desanv01/Flight-Controller-V2/docs/overview.md

# Flight Controller V2

STM32H743VIT6 controller adapted from an open-hardware reference design for externally regulated power, a signal-only OpenESC interface, exact Nano-Fit integration and a pinned ArduPilot target. The repository preserves the hardware adaptation, firmware work and vendor engineering packages.

Engineering prototype. Manufacturer data and a pinned firmware target are available. Neutral firmware build status is recorded separately; powered-board, sensor and flight qualification remain pending.

[Contribution statement](../CONTRIBUTIONS.md) · [Source](../hardware/README.md) · [History](development/timeline.md).
