desanv01/Flight-Controller-V2/docs/portfolio/resume-bullets.md

# Resume-ready project wording

Project: **Flight Controller V2**. Contributor: Desan Vasu. Dates reflect technical records, not employment dates. Fabrication external. Select bullets for the intended role rather than using all of them.

- Adapted an open-hardware STM32H743 controller for externally regulated power, a signal-only ESC boundary and exact Nano-Fit integration.
- Configured and reproduced a pinned ArduPilot target, preserving firmware defaults, source provenance and board-specific interface mappings.
- Reconciled manufacturer BOM/placement data and documented hardware, firmware and props-off validation requirements.

Do not add flight performance, deployment, production reliability or successful powered sensor tests without measured evidence. Original upstream and reference-library work remains separately credited.
