desanv01/Flight-Controller-V2/fabrication/jlcpcb/fabrication/drill-report.txt

Drill report for Flight Controller.kicad_pcb
Created on 2026-10-14T18:28:30

Copper Layer Stackup:
    =============================================================
    L1 :  F.Cu (SIG PWR)            front
    L2 :  In1.Cu (GND)              in1
    L3 :  In2.Cu (SIG PWR)          in2
    L4 :  In3.Cu(GND SIG)           in3
    L5 :  In4.Cu (GND)              in4
    L6 :  B.Cu (SIG PWR)            back

Drill file 'Flight Controller-PTH.drl' contains
    plated through holes:
    =============================================================
    T1  0.250mm  0.0098"  (359 holes))
    T2  0.400mm  0.0157"  (12 holes))
    T3  0.500mm  0.0197"  (32 holes))
    T4  1.200mm  0.0472"  (2 holes))
    T5  1.600mm  0.0630"  (2 holes))
    T6  3.200mm  0.1260"  (4 holes))

    Total plated holes count 411

Drill file 'Flight Controller-NPTH.drl' contains
    unplated through holes:
    =============================================================
    T1  1.300mm  0.0512"  (1 hole)

    Total unplated holes count 1
