desanv01/Flight-Controller-V2/CONTRIBUTIONS.md

# Contributions

**Desan Vasu** ([desanv01](https://github.com/desanv01)) confirmed on 14 October 2026 that the project activities, except physical fabrication, were performed by him. This includes requirements, design/adaptation, CAD review, firmware-related work, build activity, integration preparation, soldering and test activity. Original upstream authorship remains credited separately.

Documented development period: 26 August–6 October 2026. These dates are based on technical records and are not a confirmed employment period or job title.

The repository documents available artifacts and saved/repeated checks. Personal activity confirmation does not establish a particular measured test passed: powered-board, sensor, thermal and flight qualification remain unestablished in the provided evidence. Fabrication was external and is not claimed as personal manufacture.

The foundational upstream PCB, original target firmware and upstream tests belong to the credited upstream contributors; Desan is credited for the documented project adaptation/integration work.
