desanv01/Flight-Controller-V2/docs/development/timeline.md

# Development timeline

Historical dates below come from project records; new import commits use the actual publication date.

| Period | Milestone | Source status | Tag |
|---|---|---|---|
| 2026-08-26 to 2026-08-27 | [Research and architecture baseline](milestones/01-research.md) | Technical records; native fragment archive | `v2-01-research` |
| 2026-08-28 to 2026-09-07 | [Circuit selection and subsystem boundaries](milestones/02-selection.md) | Technical records; native fragment archive | `v2-02-selection` |
| 2026-09-07 | [MCU resource and interface freeze](milestones/03-interface-freeze.md) | Technical records; native fragment archive | `v2-03-interface-freeze` |
| 2026-09-07 | [KiCad foundation](milestones/04-foundation.md) | Technical records; native fragment archive | `v2-04-foundation` |
| 2026-09-07 to 2026-09-08 | [STM32H743 core capture](milestones/05-mcu-core.md) | Technical records; native fragment archive | `v2-05-mcu-core` |
| 2026-09-08 to 2026-09-09 | [Power tree and correction sequence](milestones/06-power.md) | Technical records; native fragment archive | `v2-06-power` |
| 2026-09-09 | [IMU and barometer capture](milestones/07-sensors.md) | Technical records; native fragment archive | `v2-07-sensors` |
| 2026-09-09 to 2026-09-10 | [External interfaces and correction closeout](milestones/08-interfaces.md) | Technical records; native fragment archive | `v2-08-interfaces` |
| 2026-09-10 | [Schematic, footprint and BOM review](milestones/09-schematic-review.md) | Technical records; native fragment archive | `v2-09-schematic-review` |
| 2026-09-10 | [Four-layer placement study](milestones/10-placement.md) | Technical records; native fragment archive | `v2-10-placement` |
| 2026-09-10 to 2026-09-11 | [Initial routing and blockers](milestones/11-routing.md) | Technical records; native fragment archive | `v2-11-routing` |

## Later milestones

V2 imports the credited upstream baseline, RC1, external-power/Nano-Fit/signal-only EVT1, pinned firmware source, vendor metadata variants, JLC pair corrections and October bench guides. See source tags and bench-guides.

Neutral naming, metadata reconciliation, source checks, regenerated exports and portfolio presentation are publication work on 14 October 2026. Original exact names/paths remain in private provenance; public hashes describe the transformed source. [Archive](../../archive/README.md).
