desanv01/Flight-Controller-V2/docs/development/milestones/07-sensors.md

# IMU and barometer capture

Version: V2. Historical evidence period: 2026-09-09. Imported: 14 October 2026.

This milestone preserves technical records. Exact source recovery is recorded separately; document dates do not establish employment dates or physical test completion.

- [FC_REV_A_STAGE_06_CONTROL_REVIEW_2026-09-09.md](../records/07-sensors/FC_REV_A_STAGE_06_CONTROL_REVIEW_2026-09-09.md)
- [FC_REV_A_STAGE_06_DISPOSITION_AND_STAGE_07_ENTRY_2026-09-09.md](../records/07-sensors/FC_REV_A_STAGE_06_DISPOSITION_AND_STAGE_07_ENTRY_2026-09-09.md)
- [FC_REV_A_STAGE_06_IMU_BAROMETER_CIRCUITS_2026-09-09.md](../records/07-sensors/FC_REV_A_STAGE_06_IMU_BAROMETER_CIRCUITS_2026-09-09.md)
