desanv01/Flight-Controller-V2/docs/development/milestones/06-power.md

# Power tree and correction sequence

Version: V2. Historical evidence period: 2026-09-08 to 2026-09-09. Imported: 14 October 2026.

This milestone preserves technical records. Exact source recovery is recorded separately; document dates do not establish employment dates or physical test completion.

- [FC_REV_A_CHANGE_CONTROL_CM5_HOSTING_AND_STAGE05_CONDITIONAL_RELEASE_2026-09-09.md](../records/06-power/FC_REV_A_CHANGE_CONTROL_CM5_HOSTING_AND_STAGE05_CONDITIONAL_RELEASE_2026-09-09.md)
- [FC_REV_A_STAGE_05_CONTROL_REVIEW_2026-09-08.md](../records/06-power/FC_REV_A_STAGE_05_CONTROL_REVIEW_2026-09-08.md)
- [FC_REV_A_STAGE_05_POWER_TREE_PROTECTION_MONITORING_2026-09-08.md](../records/06-power/FC_REV_A_STAGE_05_POWER_TREE_PROTECTION_MONITORING_2026-09-08.md)
- [FC_REV_A_STAGE_05_R10_CONTROL_REVIEW_2026-09-08.md](../records/06-power/FC_REV_A_STAGE_05_R10_CONTROL_REVIEW_2026-09-08.md)
- [FC_REV_A_STAGE_05_R12_CONTROL_REVIEW_2026-09-08.md](../records/06-power/FC_REV_A_STAGE_05_R12_CONTROL_REVIEW_2026-09-08.md)
- [FC_REV_A_STAGE_05_R14_CONTROL_REVIEW_2026-09-09.md](../records/06-power/FC_REV_A_STAGE_05_R14_CONTROL_REVIEW_2026-09-09.md)
- [FC_REV_A_STAGE_05_R16_CONTROL_REVIEW_2026-09-09.md](../records/06-power/FC_REV_A_STAGE_05_R16_CONTROL_REVIEW_2026-09-09.md)
- [FC_REV_A_STAGE_05_R18_CONTROL_REVIEW_2026-09-09.md](../records/06-power/FC_REV_A_STAGE_05_R18_CONTROL_REVIEW_2026-09-09.md)
- [FC_REV_A_STAGE_05_R8_CONTROL_REVIEW_2026-09-08.md](../records/06-power/FC_REV_A_STAGE_05_R8_CONTROL_REVIEW_2026-09-08.md)
