desanv01/Flight-Controller-V2/docs/development/milestones/05-mcu-core.md

# STM32H743 core capture

Version: V2. Historical evidence period: 2026-09-07 to 2026-09-08. Imported: 14 October 2026.

This milestone preserves technical records. Exact source recovery is recorded separately; document dates do not establish employment dates or physical test completion.

- [FC_REV_A_STAGE_04_CONTROL_REVIEW_2026-09-08.md](../records/05-mcu-core/FC_REV_A_STAGE_04_CONTROL_REVIEW_2026-09-08.md)
- [FC_REV_A_STAGE_04_H743_CORE_2026-09-07.md](../records/05-mcu-core/FC_REV_A_STAGE_04_H743_CORE_2026-09-07.md)
