desanv01/Flight-Controller-V2/docs/development/milestones/04-foundation.md

# KiCad foundation

Version: V2. Historical evidence period: 2026-09-07. Imported: 14 October 2026.

This milestone preserves technical records. Exact source recovery is recorded separately; document dates do not establish employment dates or physical test completion.

- [FC_REV_A_STAGE_03_ENTRY_BRIEF_2026-09-07.md](../records/04-foundation/FC_REV_A_STAGE_03_ENTRY_BRIEF_2026-09-07.md)
- [FC_REV_A_STAGE_03_KICAD_FOUNDATION_2026-09-07.md](../records/04-foundation/FC_REV_A_STAGE_03_KICAD_FOUNDATION_2026-09-07.md)
