desanv01/Flight-Controller-V2/archive/upstream-baseline/README.md

# Credited FCV2 source baseline

Archived hardware and firmware-target text at upstream commit 0a60da1767061623549253d3cef8649f93ea052c. This subset records source provenance; standard/custom model dependencies are not all bundled here. Use current hardware for the portable V2 design. Upstream CERN-OHL-S-2.0 license and contributor credits apply. This is inherited source, not Desan's original baseline design.
