desanv01/Flight-Controller-V2/fabrication/jlcpcb/assembly/J12-HAND-INSTALL-BOM.csv

Designator | Manufacturer | Exact MPN | Quantity | Requirement
J12 | Molex | 105311-1202 | 1 | Black, 0.38 um gold; no tin substitute; install after JLCPCB SMT assembly
