desanv01/Flight-Controller-V2/fabrication/jlcpcb/exports/board.step

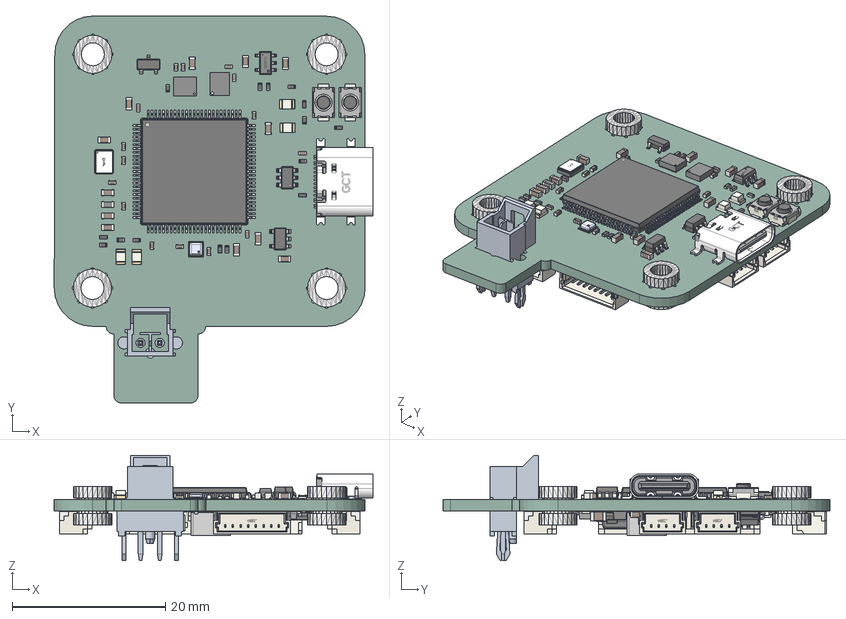
[picture p3: CAD file, 2026-10-14]
fabrication/jlcpcb/exports/board.step
41.6 x 50.5 x 13.7 mm
C_0603_1608Metric x 21
C_0402_1005Metric x 26
R_0402_1005Metric x 29
L_0603_1608Metric
LED_0805_2012Metric x 4
SOT-23
USB4110-GF-A_revB(1) MF
product0 x 4
BMI270
BMP388
ICM-42688-P
SOT-23-5
SOT-25-5_L3.0-W1.6-H1.3-LS2.8-P0.95
OSC-SMD_4P-L3.2-W2.5-CJ13-320001210A20
SW_Push_SPST_NO_Alps_SKRK x 2
SOT-23-6 x 2
LQFP-100_14x14mm_P0.5mm
CONN-SMD_SR1.00-WS-4P x 7
Crystal_SMD_3225-4Pin_3.2x2.5mm
C_0805_2012Metric
SOIC-8_3.9x4.9mm_P1.27mm
SOT-23-3L_L2.9-W1.6-H1.1-LS2.8-P0.95
IND-SMD_L5.4-W5.2-H3.0
D_SMF
CONN-SMD_SR1.00-WS-8P
SOD-123FL_L2.8-W1.8-LS3.7-RD-1
W25Q32JWSSIQ
JST_SH_SM06B-SRSS-TB_1x06-1MP_P1.00mm_Horizontal x 2
TSSOP-28_L9.7-W4.4-P0.65-LS6.4-BL-EP-2
Flight Controller_PCB
