desanv01/Flight-Controller-V2/fabrication/jlcpcb/source/hardware/3D models/ICM-42688-P.step

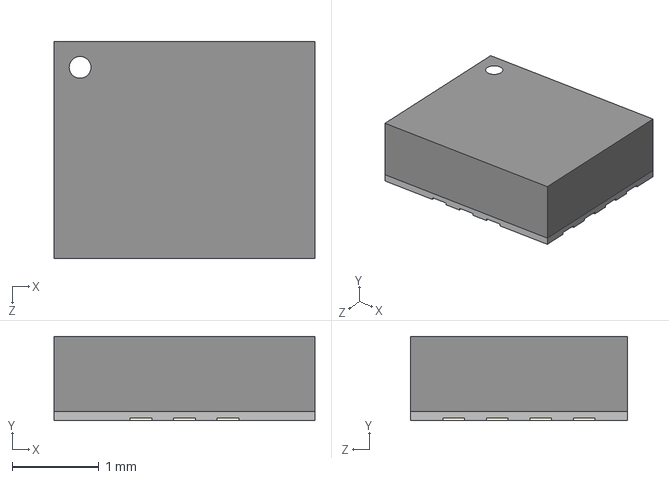
[picture p4: CAD file, 2026-10-14]
fabrication/jlcpcb/source/hardware/3D models/ICM-42688-P.step
3.00 x 0.97 x 2.50 mm
