desanv01/Flight-Controller-V2/fabrication/pcbway/source/hardware/3D models/W25Q128JVSIQ.step

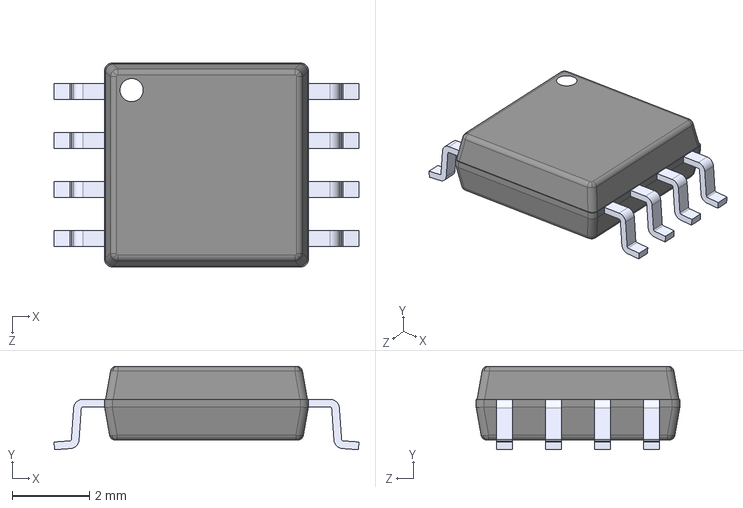
[picture p5: CAD file, 2026-10-14]
fabrication/pcbway/source/hardware/3D models/W25Q128JVSIQ.step
7.90 x 2.16 x 5.28 mm
