desanv01/Flight-Controller-V2/hardware/3D models/BMI270.step

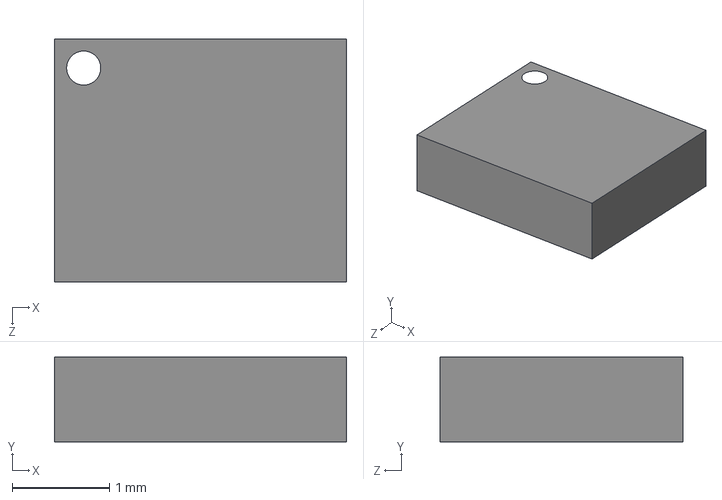
[picture p6: CAD file, 2026-10-14]
hardware/3D models/BMI270.step
3.00 x 0.87 x 2.50 mm
