desanv01/Flight-Controller-V2/fabrication/jlcpcb/source/hardware/3D models/IND-SMD_L5.4-W5.2-H3.0.step

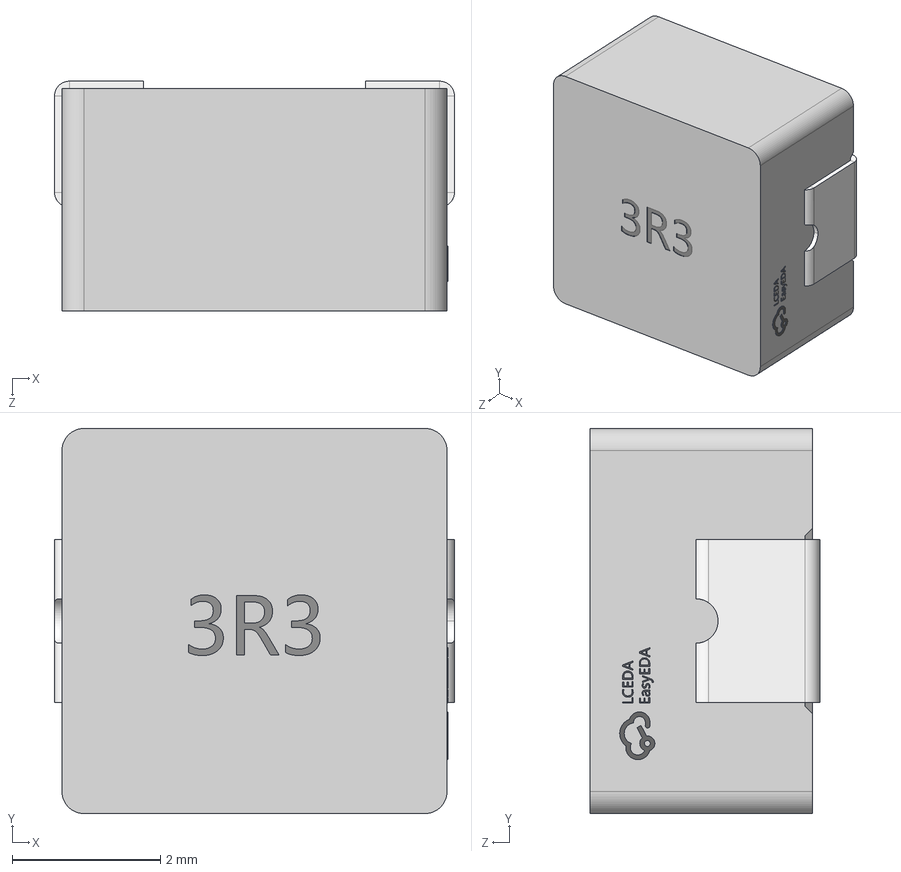
[picture p7: CAD file, 2026-10-14]
fabrication/jlcpcb/source/hardware/3D models/IND-SMD_L5.4-W5.2-H3.0.step
5.40 x 5.20 x 3.10 mm
