desanv01/Flight-Controller-V2/fabrication/pcbway/source/hardware/3D models/4pconnector1mm.step

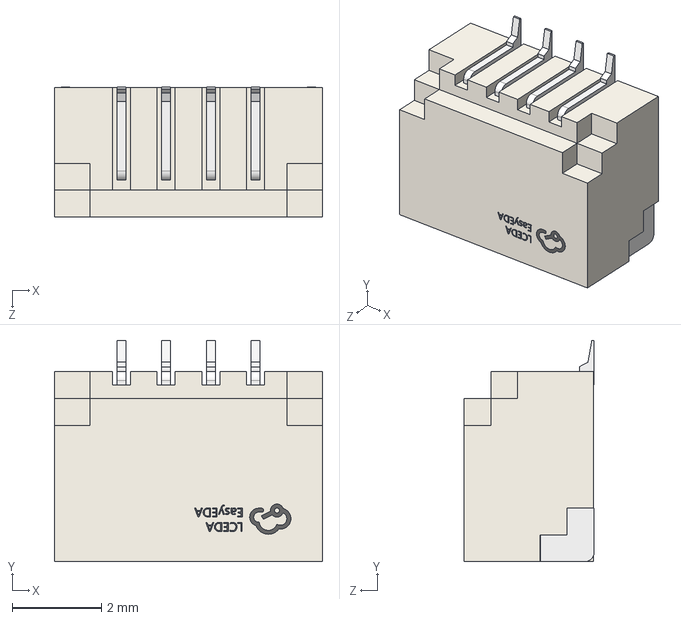
[picture p8: CAD file, 2026-10-14]
fabrication/pcbway/source/hardware/3D models/4pconnector1mm.step
6.00 x 4.95 x 2.91 mm
