desanv01/Flight-Controller-V2/hardware/3D models/8pconn.step

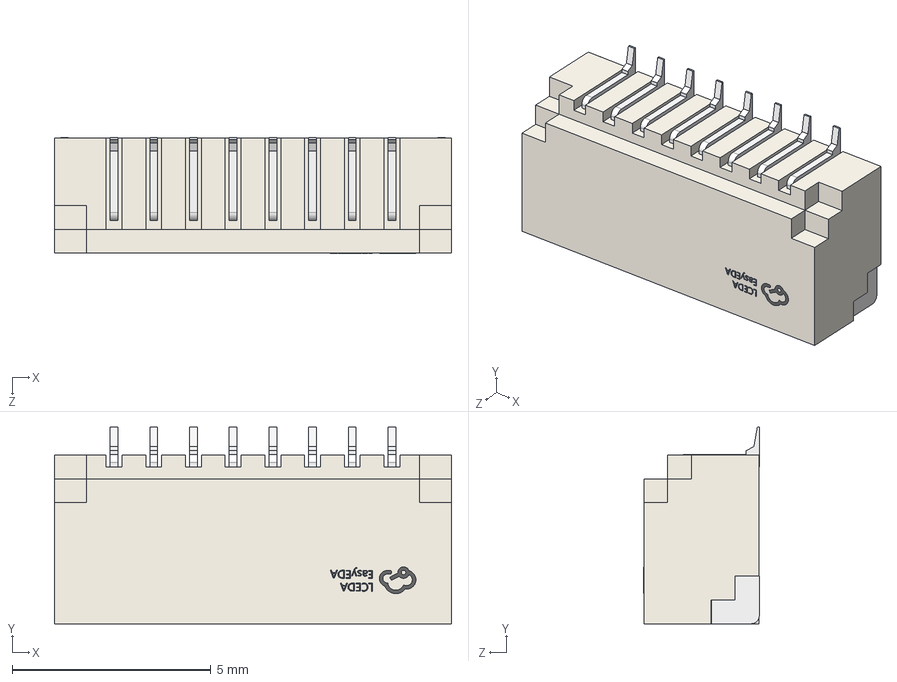
[picture p9: CAD file, 2026-10-14]
hardware/3D models/8pconn.step
10.0 x 4.95 x 2.91 mm
