desanv01/Flight-Controller-V2/fabrication/jlcpcb/source/hardware/3D models/BMP388.step

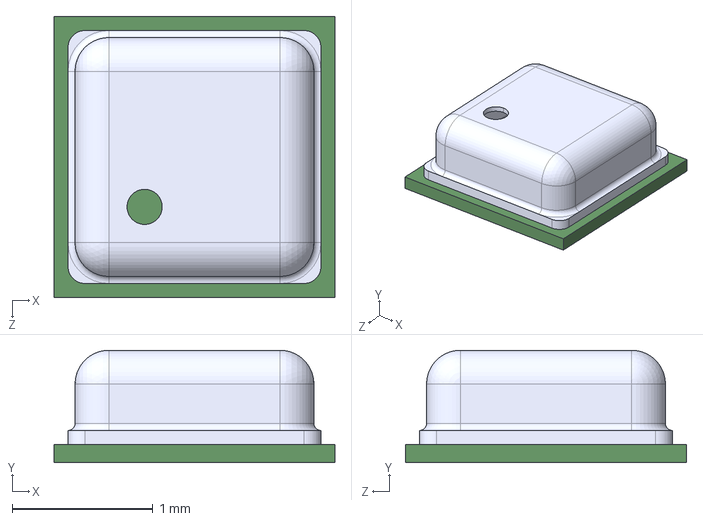
[picture p10: CAD file, 2026-10-14]
fabrication/jlcpcb/source/hardware/3D models/BMP388.step
2.00 x 0.8 x 2.00 mm
