desanv01/Flight-Controller-V2/fabrication/pcbway/source/hardware/3D models/AO3407A.step

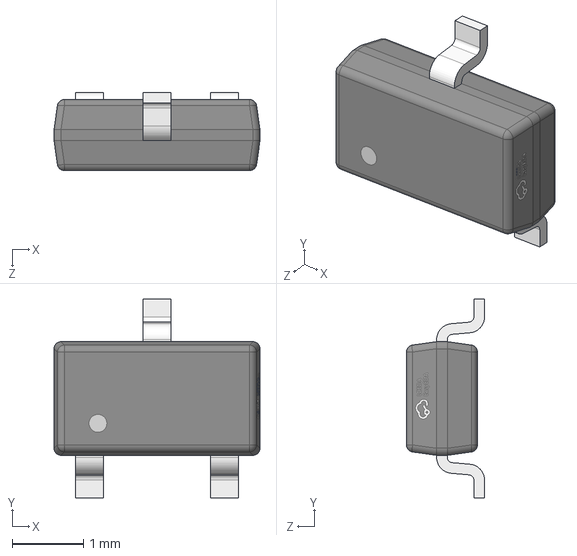
[picture p11: CAD file, 2026-10-14]
fabrication/pcbway/source/hardware/3D models/AO3407A.step
2.90 x 2.80 x 1.10 mm
