desanv01/Flight-Controller-V2/hardware/3D models/AT7456E.step

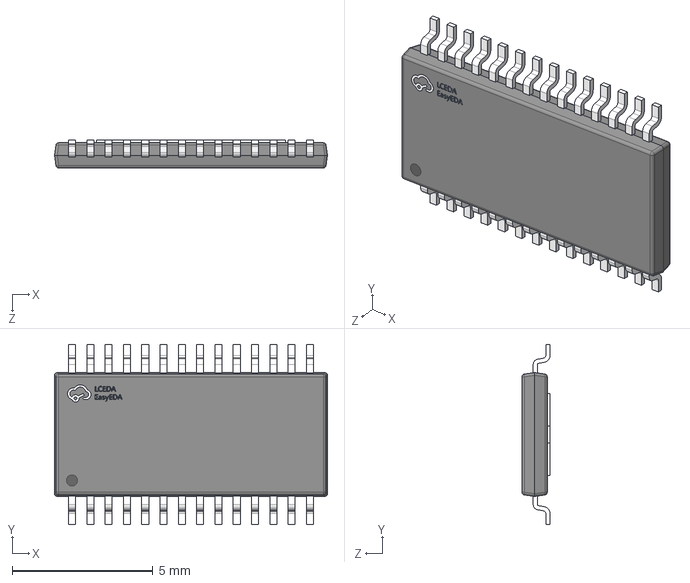
[picture p12: CAD file, 2026-10-14]
hardware/3D models/AT7456E.step
9.70 x 6.40 x 1.00 mm
