desanv01/Flight-Controller-V2/hardware/3D models/(HSE)OSC-SMD_4P-L3.2-W2.5-CJ13-320001210A20.step

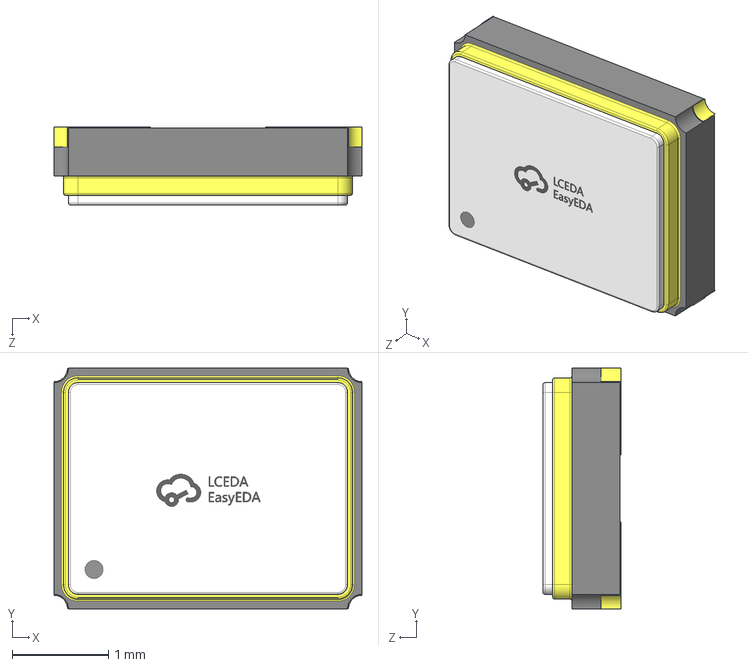
[picture p13: CAD file, 2026-10-14]
hardware/3D models/(HSE)OSC-SMD_4P-L3.2-W2.5-CJ13-320001210A20.step
3.20 x 2.50 x 0.811 mm
