desanv01/Flight-Controller-V2/hardware/3D models/USB4110GFA.step

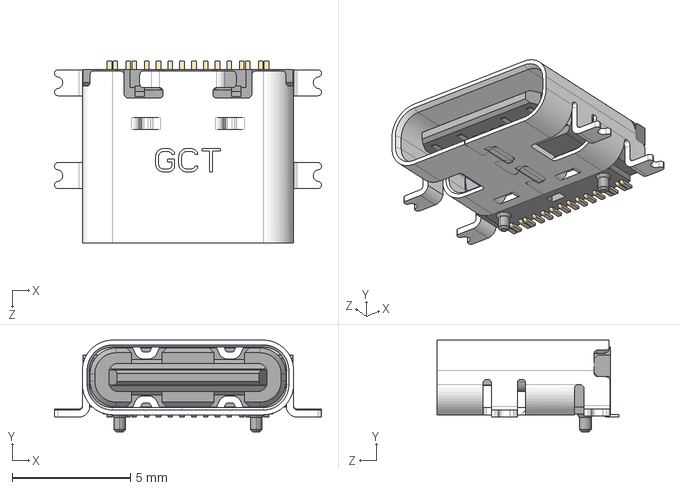
[picture p15: CAD file, 2026-10-14]
hardware/3D models/USB4110GFA.step
11.3 x 3.89 x 7.70 mm
