desanv01/Flight-Controller-V2/fabrication/jlcpcb/source/hardware/3D models/AP7343 .step

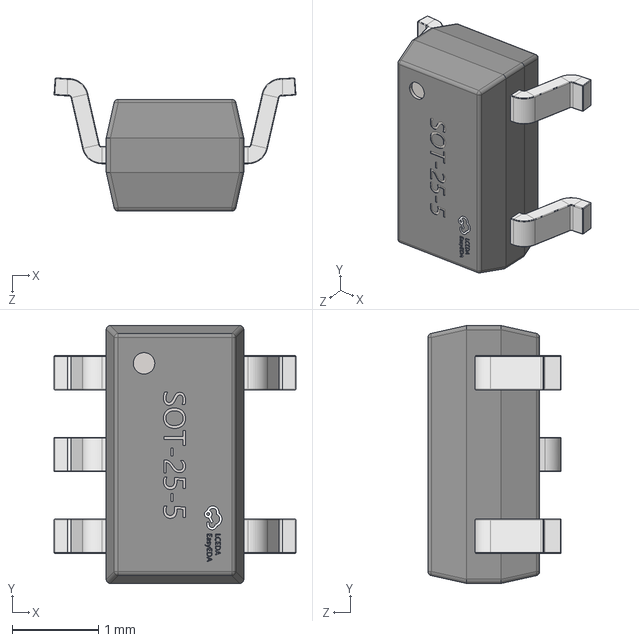
[picture p16: CAD file, 2026-10-14]
fabrication/jlcpcb/source/hardware/3D models/AP7343 .step
2.81 x 3.00 x 1.55 mm
