desanv01/Flight-Controller-V2/(list of files, cad)

Other CAD files:
fabrication/pcbway/exports/board.step
fabrication/jlcpcb/source/hardware/3D models/FC_washer_double_sided_2mm.step
fabrication/pcbway/source/hardware/3D models/FC_washer_double_sided_2mm.step
hardware/3D models/FC_washer_double_sided_2mm.step
