desanv01/Flight-Controller-V2/fabrication/README.md

# Manufacturing data

Select [JLCPCB](jlcpcb/README.md) or [PCBWay](pcbway/README.md) as a coherent engineering package. Each includes exact public source, its source manifest, assembly files, fresh verification and export outputs. The original names were neutralized and descriptive metadata reconciled; new public hashes are authoritative for these downloads.

V2 JLCPCB and PCBWay preserve different documented source metadata/stack snapshots. Use the JLC final BOM/CPL pair with JLC source; use PCBWay data with PCBWay source.

No fabrication order is placed by this publication and physical qualification remains pending. Confirm supplier CAM/DFM, sourcing, rotations, dimensions and board quantities before manufacture. [Engineering downloads](https://github.com/desanv01/Flight-Controller-V2/releases/tag/v2-portfolio-publication).
