desanv01/Flight-Controller-V2/fabrication/pcbway/documents/PCBWay_Fabrication_and_Order_Settings.md

# PCBWay fabrication and order settings

ENGINEERING VALIDATION EVT1 — PCBWAY FABRICATION AND ASSEMBLY RELEASE — NOT YET FLIGHT RELEASED

- 6-layer rigid PCB; 1.6 mm finished thickness; manufacturer published regular stack above.
- Outer copper 1 oz; inner copper 1 oz (selected published construction, replacing the earlier JLC ~0.5 oz internal metadata).
- ENIG; green solder mask; white silkscreen; double-sided mixed SMT/THT assembly.
- Finished Edge.Cuts envelope: `40.575 x 50.500 mm`; 40.5 mm body plus compact integral Nano-Fit tab; 30.5 mm M3 pattern.
- USB: 90 ohm differential ±10%; 0.1537 mm width / 0.2032 mm edge gap; PCBWay impedance confirmation required.
- Separate PTH and NPTH Excellon files. No new filled/capped-via requirement is introduced.
- Manufacturer-created 2 x 2 routed assembly panel with rails; single-board Gerbers remain source of truth.
- No design, material, net, component or part-number change without written approval.
