desanv01/Flight-Controller-V2/fabrication/jlcpcb/SHA256SUMS.csv

path | bytes | sha256
assembly/FC_EVT1-JLCPCB-BOM-FINAL.csv | 7840 | 5b94f42e98bb50876649b4d324ba25d7c416c0bd693d90f9de5a7ad50fe1b310
assembly/FC_EVT1-JLCPCB-CPL-FINAL.csv | 3668 | 96f2db6e78cb4b7a9fab600835ba0a9443f55a6c0e920dc661057a011769aab4
assembly/J12-HAND-INSTALL-BOM.csv | 157 | 71104588511064477e29668882c3db73aecbd2b95a4f4be22f6b5d6d3f23c96f
assembly/reference/FC_EVT1-BOM.csv | 8262 | be1517c8ff4a4a6613ca031192bc964233e27cd7a2e1280f38c6fd02e8a99620
assembly/reference/FC_EVT1-CPL-JLCPCB.csv | 4662 | 8ec238fa7a3ce3494cc89ce2108c983d17bfac70abacb2191e8948b2071f71cc
assembly/reference/FC_EVT1-CPL-KiCad.csv | 11904 | ca3d230f4cb103ad682e82bd5f3d5ae87ade87d94adecc47c9d312b8dba132e9
documents/CHANGE_MANIFEST.md | 1918 | ab804ee89236a9ee5e9aec96a1b1623f196fa40686a3b78b3723c8d5bbcf80d2
documents/FIRMWARE_RELEASE_NOTE.md | 986 | 35805b37b96357b29bc295bedce3e3a251a0396a4eb585dabc100d9d16724961
documents/JLCPCB_IMPEDANCE_RECORD.md | 724 | 31d905b5a3da8de550fcdcfb85d4a68ea9d0ed15b4cf6238e6f39db8e4c54cc1
documents/JLCPCB_ORDER_SETTINGS.txt | 1235 | 8ffe77fb60720466434c7db849bf7ccde47e928241e71e1bf331c20eb23796de
documents/MECHANICAL_RELEASE_NOTE.md | 736 | 221ca624dacb333461b0323a68617b76b7987c0a63d30494c488935b07bc7e85
documents/PCBWAY_FALLBACK_NOTES.md | 741 | 697a88afdcb993e6b58a868e1d5a1a3563202d89a79ce1e4fc41c2e401223ac9
exports/assembly.pdf | 233099 | 0343be26e25fc4fa5d112788b60e836f3a14fc880d22f29eb699e844f1896cf7
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
verification/drc.json | 2041 | d27c3f03f35c7f82d76a973e41ed442cd26d6b3db18e9dbe71d8bc5c2dc50f1f
verification/erc-command.log | 342 | 73c2f3659d60d35001a71d40bcf0f8e0dfb2a2f7b9f79e76b1af1bb0bd6ca29e
verification/erc.json | 41943 | 291535fd4a0a94cc1e1ef1bc6e7dd41646971bfa456b98563083da0673bfea10
verification/final-upload-pair.json | 417 | a75f4a180bff57d542a4626dcd09b940646deac914d9a1ead8ac1bbc017dc3e9
verification/netlist-command.log | 194 | 90ca8ce8cf36b32eaa36189eeb8431974100a2f04ec79eaa003ea06069fc92c6
verification/netlist.xml | 300338 | b886deb90466cff71a53ed859d7196c054cc04a9da880175f7262a0004578db3
verification/publication-corrections.json | 1226 | ff983552e4fc6c9f27b514b513945e128d3f501cad09f774cebe0f52abd7ff1d
verification/summary.json | 2896 | 102d5334e3a391f265c47196b359903b62224f75f00a2cc4b341ad6e9792cee1
