desanv01/Flight-Controller-V2/fabrication/pcbway/SHA256SUMS.csv

path | bytes | sha256
assembly/FC_EVT1_PCBWAY-DNP-and-NonPurchased.csv | 739 | 428991720972373f0b045c839d49f827710fbb901aa97b1a19c7b3db474d758d
assembly/FC_EVT1_PCBWAY-SMT-Centroid-Bottom.csv | 3495 | e9ebb8173cdd00e0a3766e5243f31ba664687df96e0df585f4b35b71de7a7e2a
assembly/FC_EVT1_PCBWAY-SMT-Centroid-Top.csv | 3418 | 5621c07bc66e5558ba9f750c7f04ada1c3395b3b0d7ece59fbec699e6cd4911a
assembly/FC_EVT1_PCBWAY-SMT-Centroid.csv | 6847 | fc32a2b5e847ba9c8a2d82971864deb914b59f2706f4a2f14102996b027ee69b
assembly/FC_EVT1_PCBWAY-THT-Placement.csv | 181 | 29704dd61fcd8c41e6954b8fc4b7ff18a66dcde9b6ebe78b7d36ee6ba14727e9
assembly/FC_EVT1_PCBWAY-Turnkey-BOM.csv | 24435 | fbfe51d85a04bfd3845bfcaf64be740fc9bb0e455e19172336dbcbbe5a51d866
assembly/reference/FC_EVT1_PCBWAY-BOM-raw.csv | 27117 | 3f677b2d470f80aba2e8dbf3d6a7dc1eb5caeca22cac77444ed9251419cdfee9
assembly/reference/FC_EVT1_PCBWAY-position-raw.csv | 11904 | ca3d230f4cb103ad682e82bd5f3d5ae87ade87d94adecc47c9d312b8dba132e9
documents/CHANGE_MANIFEST.md | 754 | 22fec6e0ec677e736bcb0588bc58f87a4a966e066502c64aac3bcb332d9dc837
documents/PCBWay_Controlled_Impedance_Report.md | 1419 | f9503272b7093ed259e62ba9d16fcd38d33ed50aed33da4d8403f0b79e473775
documents/PCBWay_Fabrication_and_Order_Settings.md | 975 | 164d0e9706b3b7a2313df21338387ce9856a6b29091455cdfc7f8cd1f3ff0e3a
documents/PCBWay_J12_Sourcing_and_THT_Instructions.md | 736 | 1f9eae488c9b0987abfdb1222024fa17d17152e8b475950ea4ad6a88d9666df8
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
verification/publication-corrections.json | 226699 | 6e1bdff8cf740534fd21592b9b796aec2c12705c5b7944c8fe077a632f69c17a
verification/summary.json | 2896 | eae645395b74edbc485336db159197c6e970899bd818a5677a874eea24440d72
