desanv01/Flight-Controller-V2/docs/exports/physical-validation.pdf

# Flight Controller V2 — Physical Validation

Engineering prototype. This worksheet is blank: it is not a passed-test record. Propellers removed for all motor tests. Use current-limited regulated power and the exact source/connector contract.

Article / lot: __________________ Operator / date: __________________

# | Test / acceptance | Measured result | Sign-off

1 | Visual inspection / orientation / DNP and deleted parts
2 | Harness polarity, continuity and strain relief
3 | Unpowered rail resistance
4 | Current-limited first power-up / quiescent current
5 | Logic, analog, reference and sensor rails
6 | Continuous and transient load / voltage limits
7 | Connector/copper temperature and thermal screening
8 | USB-only isolation and powered backfeed
9 | USB enumeration / reconnect / brownout recovery
10 | Clock start and stability
11 | IMU identification, orientation and plausible data
12 | Barometer pressure response
13 | Logging/storage and external interfaces
14 | CRSF receiver-loss failsafe
15 | ESC continuity and waveform integrity
16 | Motor order/direction with propellers removed
17 | Bidirectional DShot after baseline qualification
18 | Mechanical fit / supplier CAM and sourcing review

Record limits from the exact design/vendor instructions. Resolve deviations before the next engineering gate. No flight qualification is granted by this publication.
