desanv01/Flight-Controller-V2/fabrication/jlcpcb/exports/schematic.pdf

USB-C data/debug only; VBUS isolated

On-board 5 V buck removed

Dual LDO rails (3.3V digital + 3.3V IMU)

MCU: STM32H743VIT6
ARM Cortex-M7 @ 480 MHz
2 MB Flash, 1 MB RAM
LQFP-100 Package

INA226 retained; analog battery monitor disabled

GPS + compass port (UART + I²C)

Hardware floating-point unit (FPU)

RC receiver (SBUS / ELRS UART)

16-bit/32-bit timers with PWM

2× FDCAN, USB OTG FS/HS

DJI FPV (UART + SBUS)

3× 16-bit ADC (up to 36 channels)

Built-in UART signal inversion

ICM-42688P (primary IMU) - SPI

W25Q128 flash memory (16 Mbit) - SPI

POWER/OPENESC REDESIGN IMPLEMENTED - BENCH VALIDATION REQUIRED
Derived from upstream commit 0a60da1 under CERN-OHL-S-2.0
Desan Vasu
Sheet: /
File: Flight Controller.kicad_sch
Title: Flight Controller V2

Size: User | Rev: A
KiCad E.D.A. 10.0.6 | Id: 1/5


3.0 A POWER1 load budget. External modules are not qualified here. enable pin max leave floting to enable the IC. operating on VIN UVLO. turns on when VIN > 4V, turn off when VIN < 3.6V TVS and reverse polarity protection

1) A saperate LDO for IMU to minimize the input noise

per multiple firmwares advise.

2) Legacy INA226 / VBAT_MEASURED circuitry is retained but
is not qualified as the EVT1 flight-battery failsafe source.
Production firmware defaults BATT_MONITOR=0.

VBAT_MEASURED is the node that supplies each sensor and peripheral in the FC

(pinouts and connection needs to be verified)

4) TPS54302 auxiliary 9/12 V regulator is retained unchanged.
It is not the FC +5 V source and is excluded from the selected

POWER/OPENESC REDESIGN IMPLEMENTED - BENCH VALIDATION REQUIRED
Derived from upstream commit 0a60da1 under CERN-OHL-S-2.0
Desan Vasu
Sheet: /Power/
File: power.kicad_sch

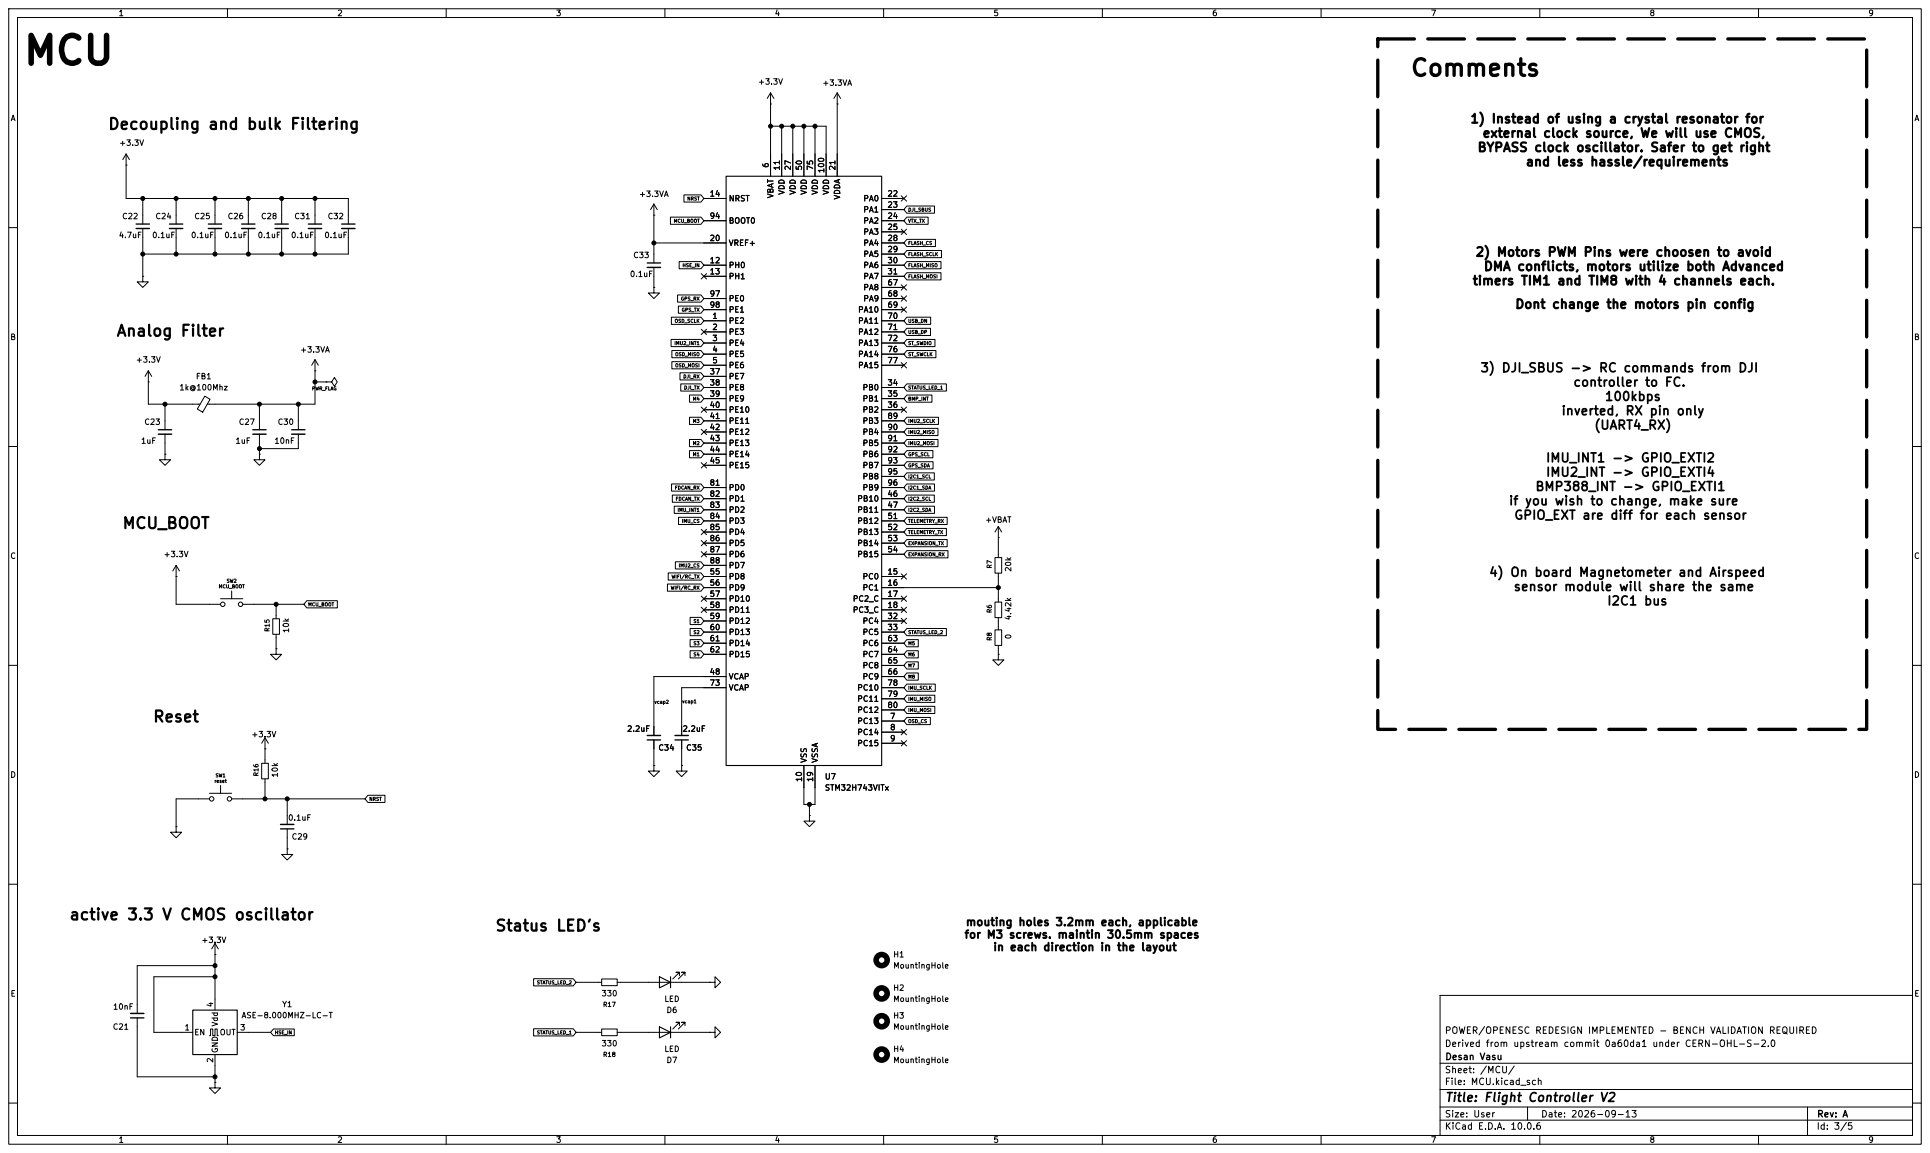
[picture p22: page 3]

Decoupling and bulk Filtering

1) Instead of using a crystal resonator for
external clock source, We will use CMOS,
BYPASS clock oscillator. Safer to get right

and less hassle/requirements

2) Motors PWM Pins were choosen to avoid
DMA conflicts, motors utilize both Advanced
timers TIM1 and TIM8 with 4 channels each.
Dont change the motors pin config

3) DJI_SBUS -> RC commands from DJI

inverted, RX pin only
(UART4_RX)

IMU_INT1 -> GPIO_EXTI2
IMU2_INT -> GPIO_EXTI4
BMP388_INT -> GPIO_EXTI1
if you wish to change, make sure
GPIO_EXT are diff for each sensor

4) On board Magnetometer and Airspeed
sensor module will share the same

mouting holes 3.2mm each, applicable
for M3 screws. maintin 30.5mm spaces
in each direction in the layout

POWER/OPENESC REDESIGN IMPLEMENTED - BENCH VALIDATION REQUIRED
Derived from upstream commit 0a60da1 under CERN-OHL-S-2.0
Desan Vasu
Sheet: /MCU/
File: MCU.kicad_sch

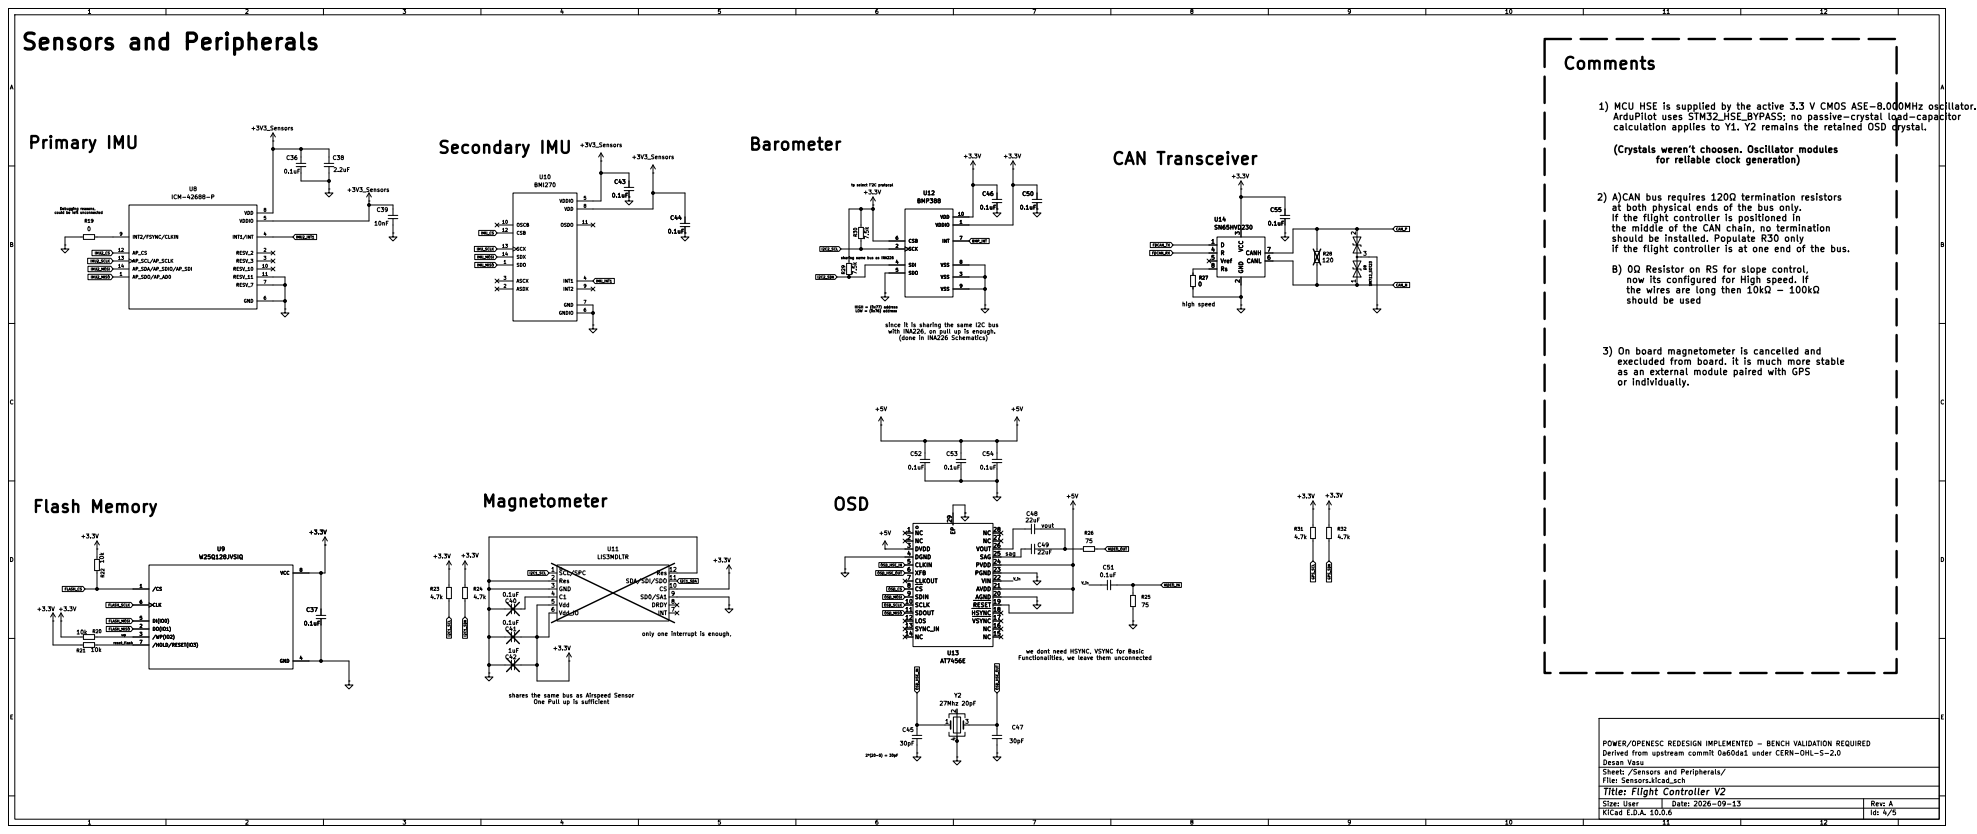
[picture p23: page 4]

1) MCU HSE is supplied by the active 3.3 V CMOS ASE-8.000MHz oscillator.
ArduPilot uses STM32_HSE_BYPASS; no passive-crystal load-capacitor
calculation applies to Y1. Y2 remains the retained OSD crystal.

Functionalities, we leave them unconnected Secondary IMU

(Crystals weren't choosen. Oscillator modules

for reliable clock generation)

2) A)CAN bus requires 120Ω termination resistors
at both physical ends of the bus only.
If the flight controller is positioned in
the middle of the CAN chain, no termination
should be installed. Populate R30 only

if the flight controller is at one end of the bus.

B) 0Ω Resistor on RS for slope control,
now its configured for High speed. If
the wires are long then 10kΩ - 100kΩ
should be used

HIGH = (0x77) address
LOW = (0x76) address since it is sharing the same I2C bus with INA226, on pull up is enough.

execluded from board. it is much more stable
as an external module paired with GPS
or individually.

only one interrupt is enough,

POWER/OPENESC REDESIGN IMPLEMENTED - BENCH VALIDATION REQUIRED
Derived from upstream commit 0a60da1 under CERN-OHL-S-2.0
Desan Vasu
Sheet: /Sensors and Peripherals/
File: Sensors.kicad_sch

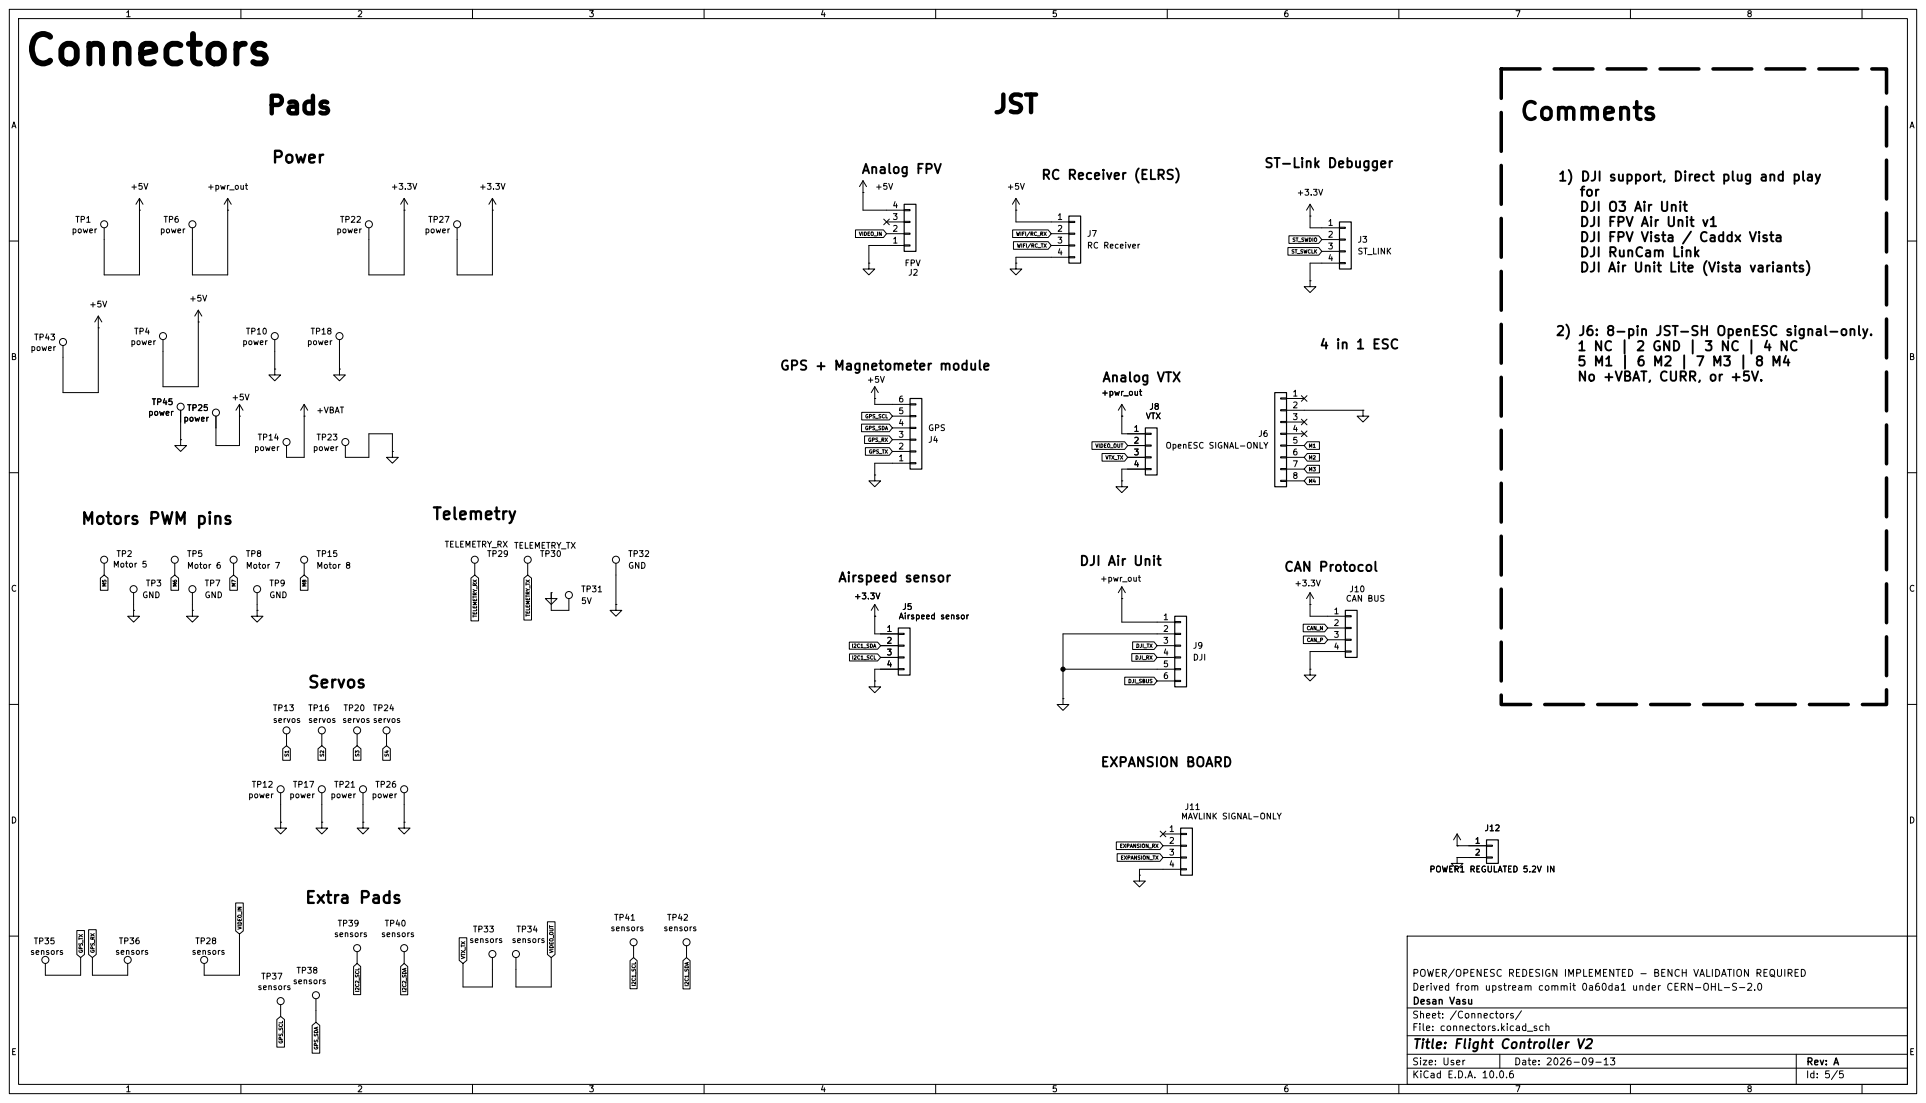
[picture p24: page 5]

1) DJI support, Direct plug and play
for
DJI O3 Air Unit
DJI FPV Air Unit v1
DJI FPV Vista / Caddx Vista
DJI RunCam Link
DJI Air Unit Lite (Vista variants)

2) J6: 8-pin JST-SH OpenESC signal-only.
1 NC | 2 GND | 3 NC | 4 NC
No +VBAT, CURR, or +5V.

POWER/OPENESC REDESIGN IMPLEMENTED - BENCH VALIDATION REQUIRED
Derived from upstream commit 0a60da1 under CERN-OHL-S-2.0
Desan Vasu
Sheet: /Connectors/
File: connectors.kicad_sch
