desanv01/Flight-Controller-V2/docs/exports/assembly.pdf

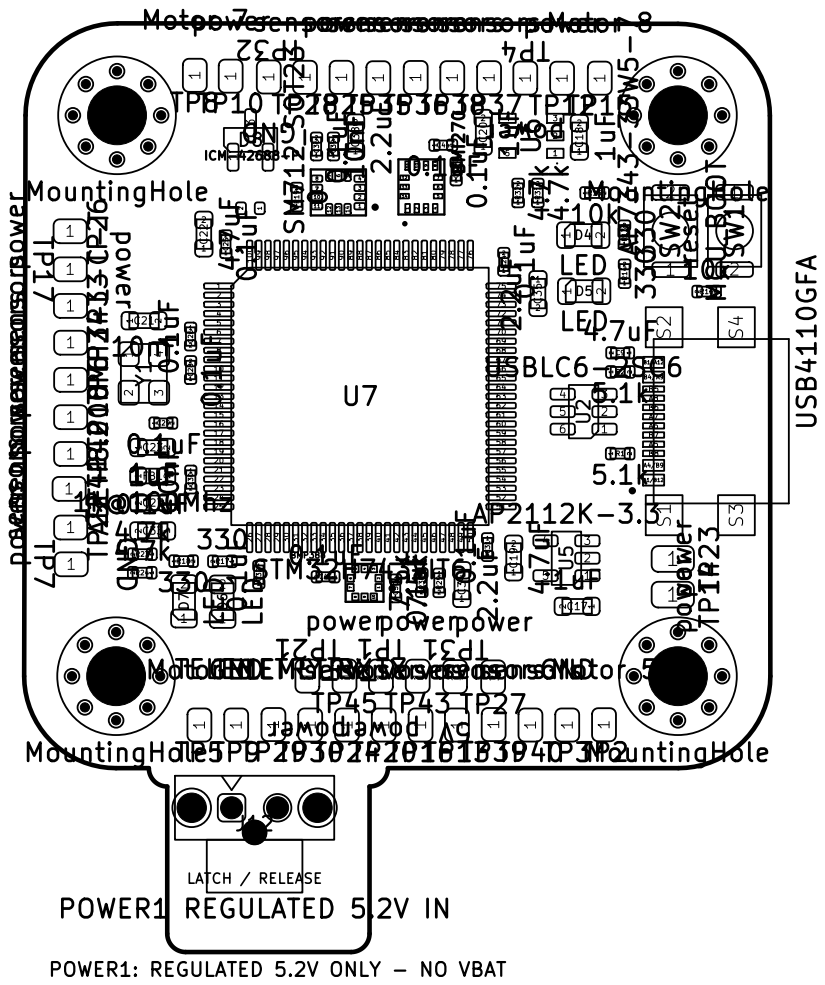
[picture p25: page 1]

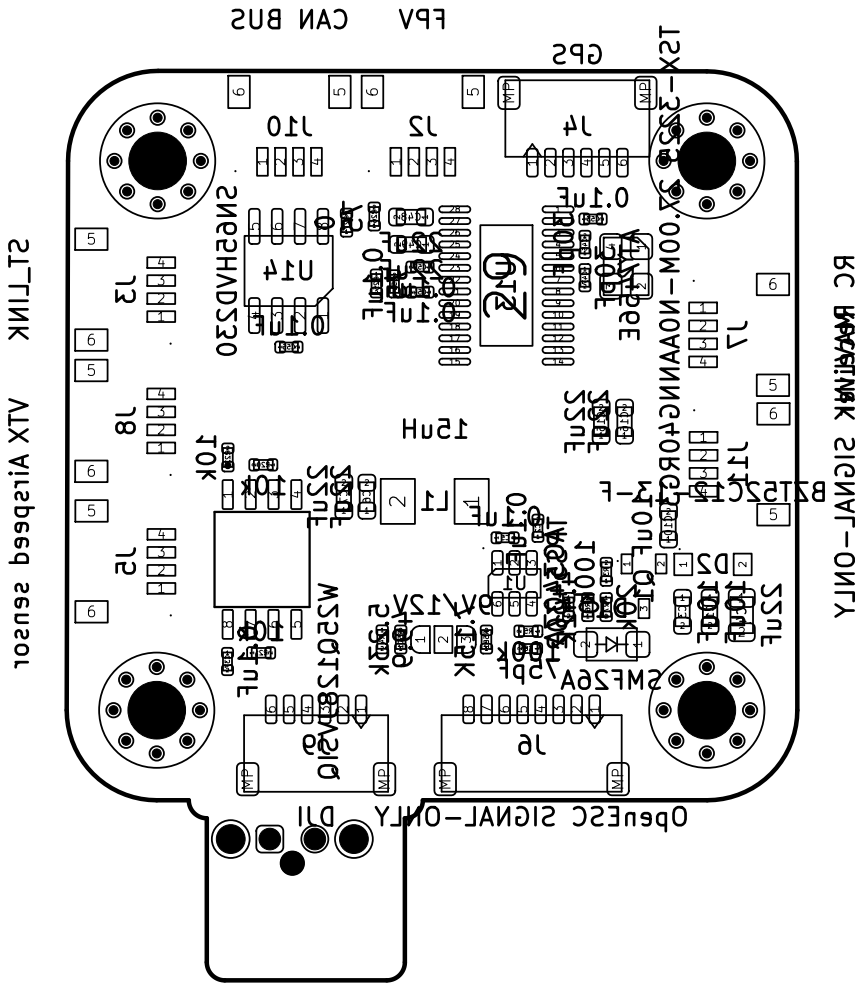
[picture p26: page 2]
