desanv01/Flight-Controller-V2/docs/exports/fabrication.pdf

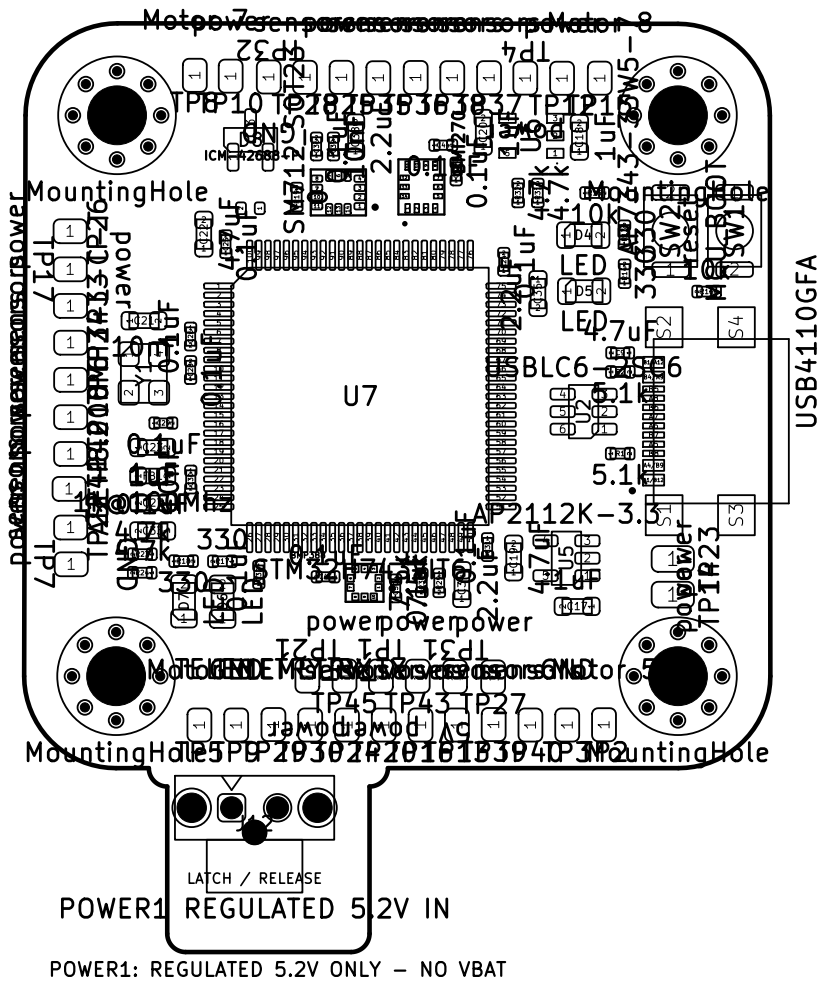
[picture p27: page 1]
