desanv01/Flight-Controller-V2/fabrication/jlcpcb/exports/assembly.pdf

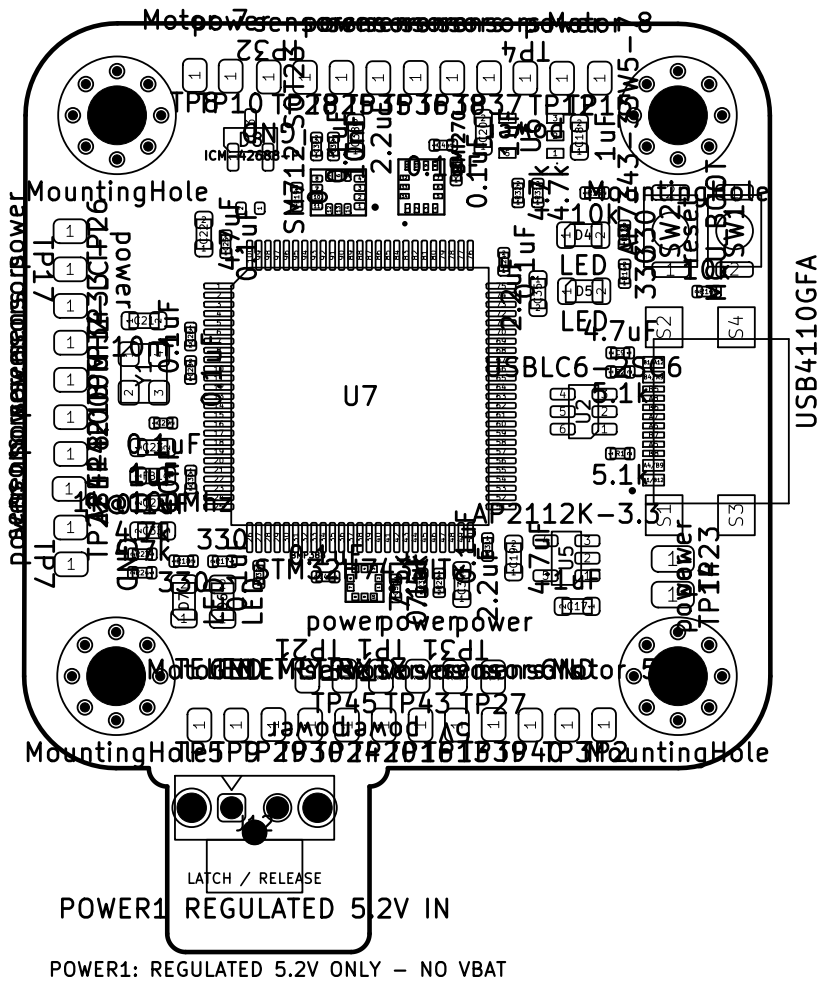
[picture p28: page 1]

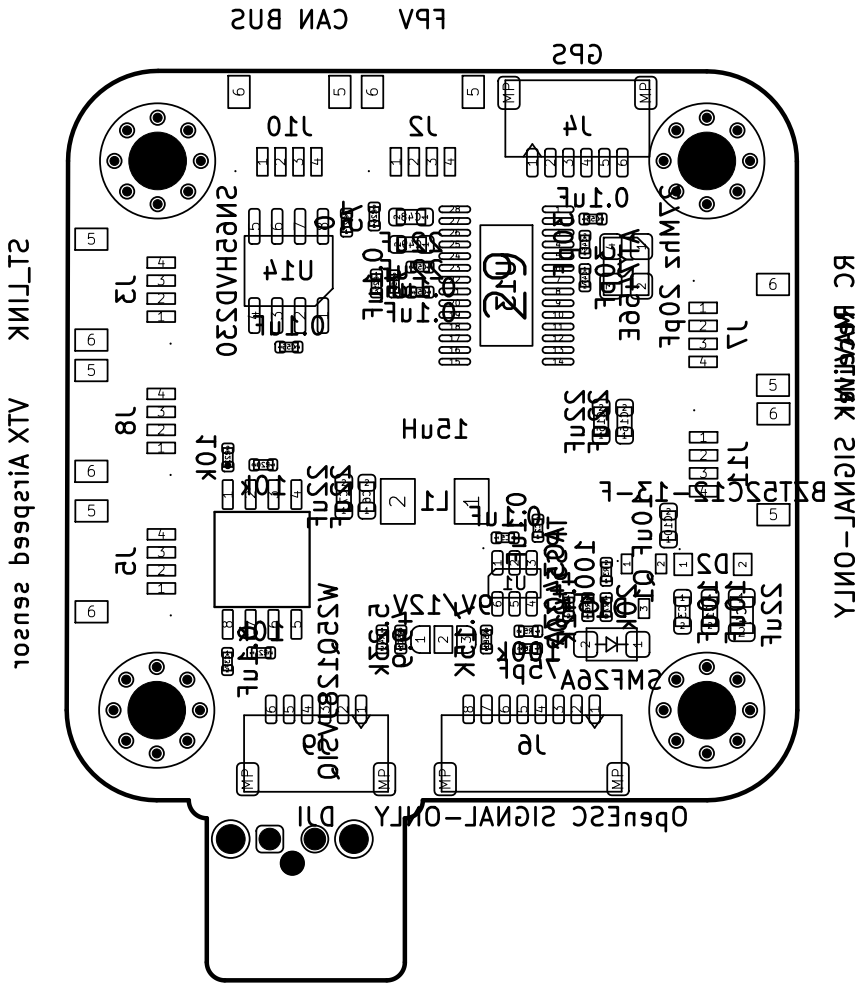
[picture p29: page 2]
