desanv01/Flight-Controller-V2/fabrication/jlcpcb/exports/fabrication.pdf

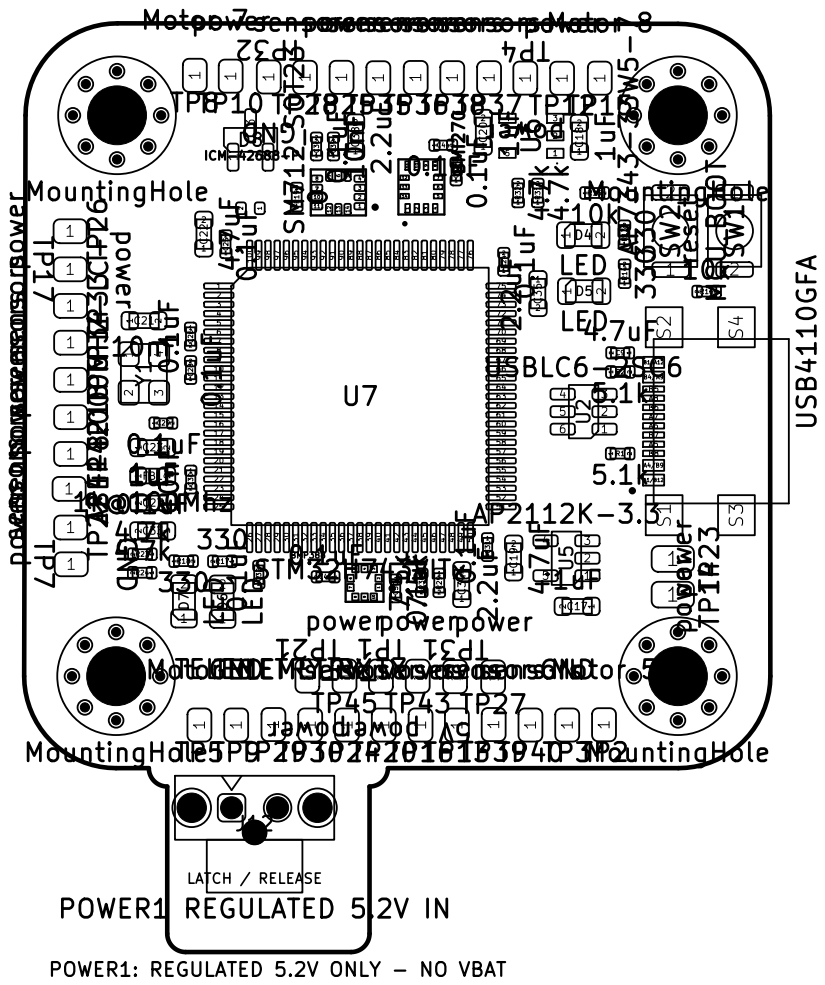
[picture p30: page 1]
