desanv01/Flight-Controller-V2/fabrication/pcbway/source/hardware/Flight Controller.kicad_pcb

## KiCad design fabrication/pcbway/source/hardware/Flight Controller.kicad_pcb (2026-10-14)

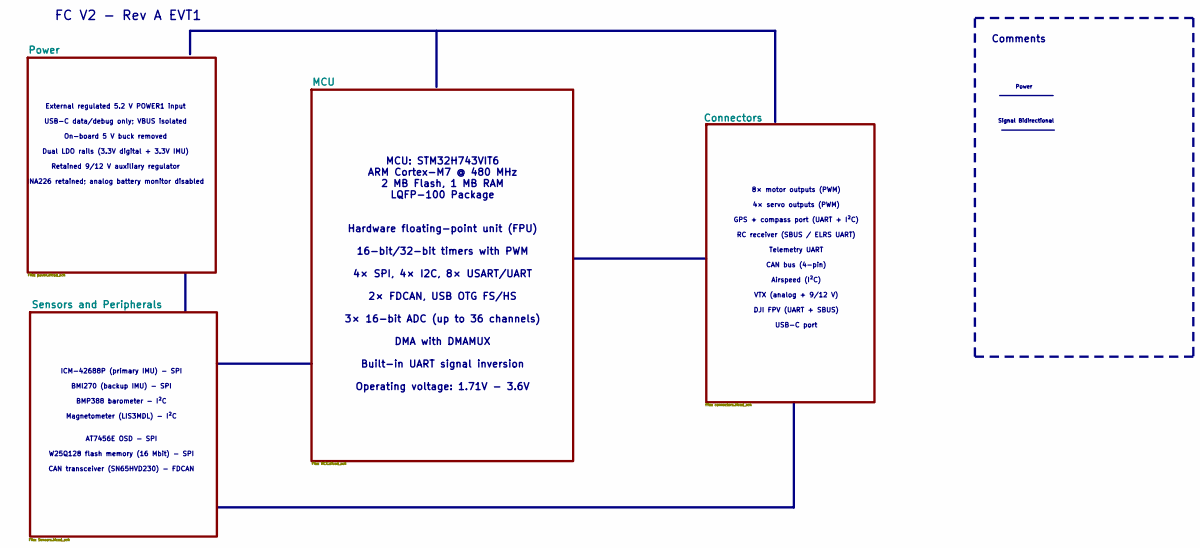
[picture p31: schematic Flight Controller.kicad_sch, Flight Controller V2]

Notes on the sheet:
FC V2 - Rev A EVT1
ICM-42688P (primary IMU) - SPI BMI270 (backup IMU) - SPI BMP388 barometer - I²C Magnetometer (LIS3MDL) - I²C AT7456E OSD - SPI W25Q128 flash memory (16 Mbit) - SPI CAN transceiver (SN65HVD230) - FDCAN
Signal Bidirectional
8× motor outputs (PWM) 4× servo outputs (PWM) GPS + compass port (UART + I²C) RC receiver (SBUS / ELRS UART) Telemetry UART CAN bus (4-pin) Airspeed (I²C) VTX (analog + 9/12 V) DJI FPV (UART + SBUS) USB-C port
Comments
External regulated 5.2 V POWER1 input USB-C data/debug only; VBUS isolated On-board 5 V buck removed Dual LDO rails (3.3V digital + 3.3V IMU) Retained 9/12 V auxiliary regulator INA226 retained; analog battery monitor disabled
MCU: STM32H743VIT6 ARM Cortex-M7 @ 480 MHz 2 MB Flash, 1 MB RAM LQFP-100 Package Hardware floating-point unit (FPU) 16-bit/32-bit timers with PWM 4× SPI, 4× I2C, 8× USART/UART 2× FDCAN, USB OTG FS/HS 3× 16-bit ADC (up to 36 channels) DMA with DMAMUX Built-in UART signal inversion Operating voltage: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
Power

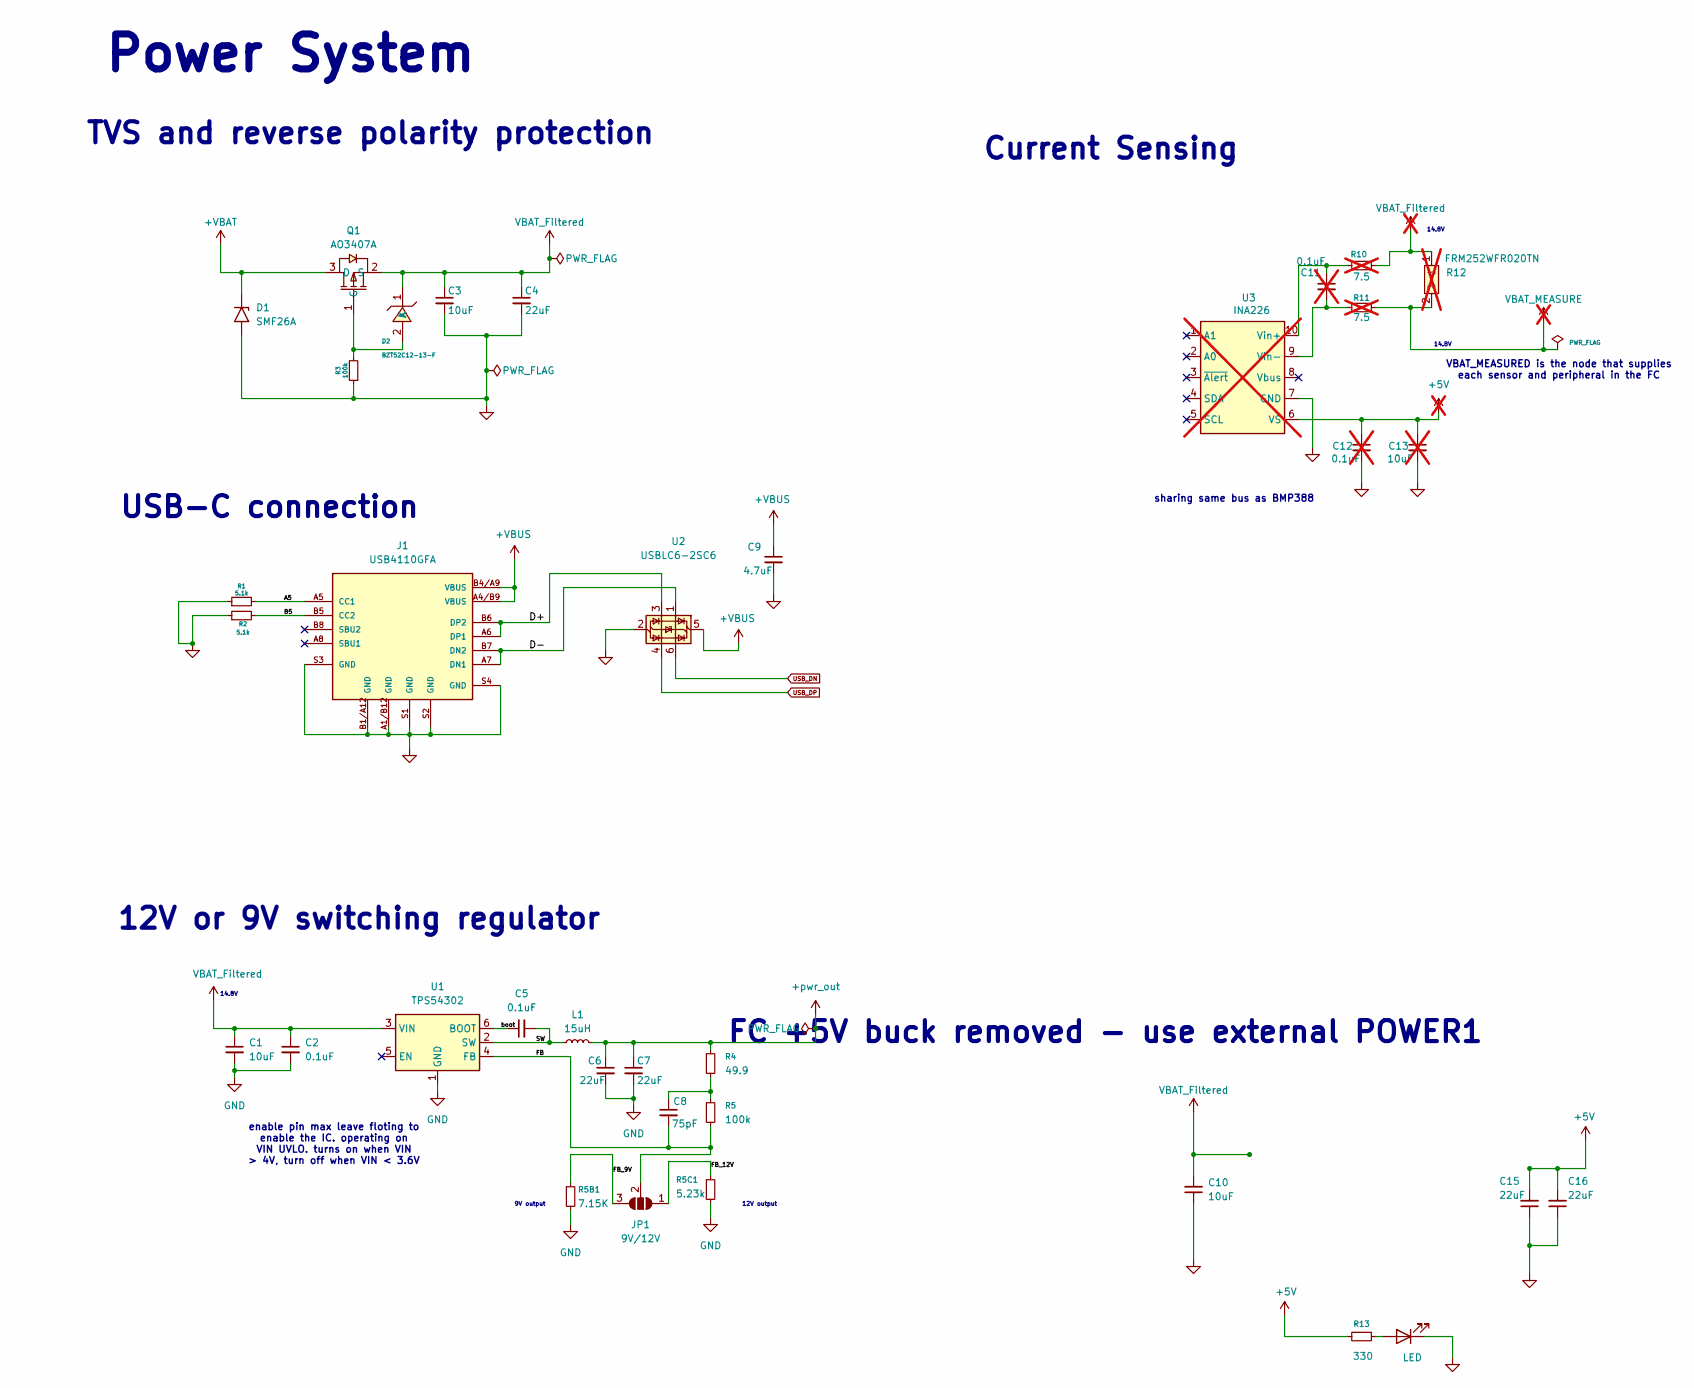
[picture p32: schematic power.kicad_sch, Flight Controller V2, part in row 1, column 1]

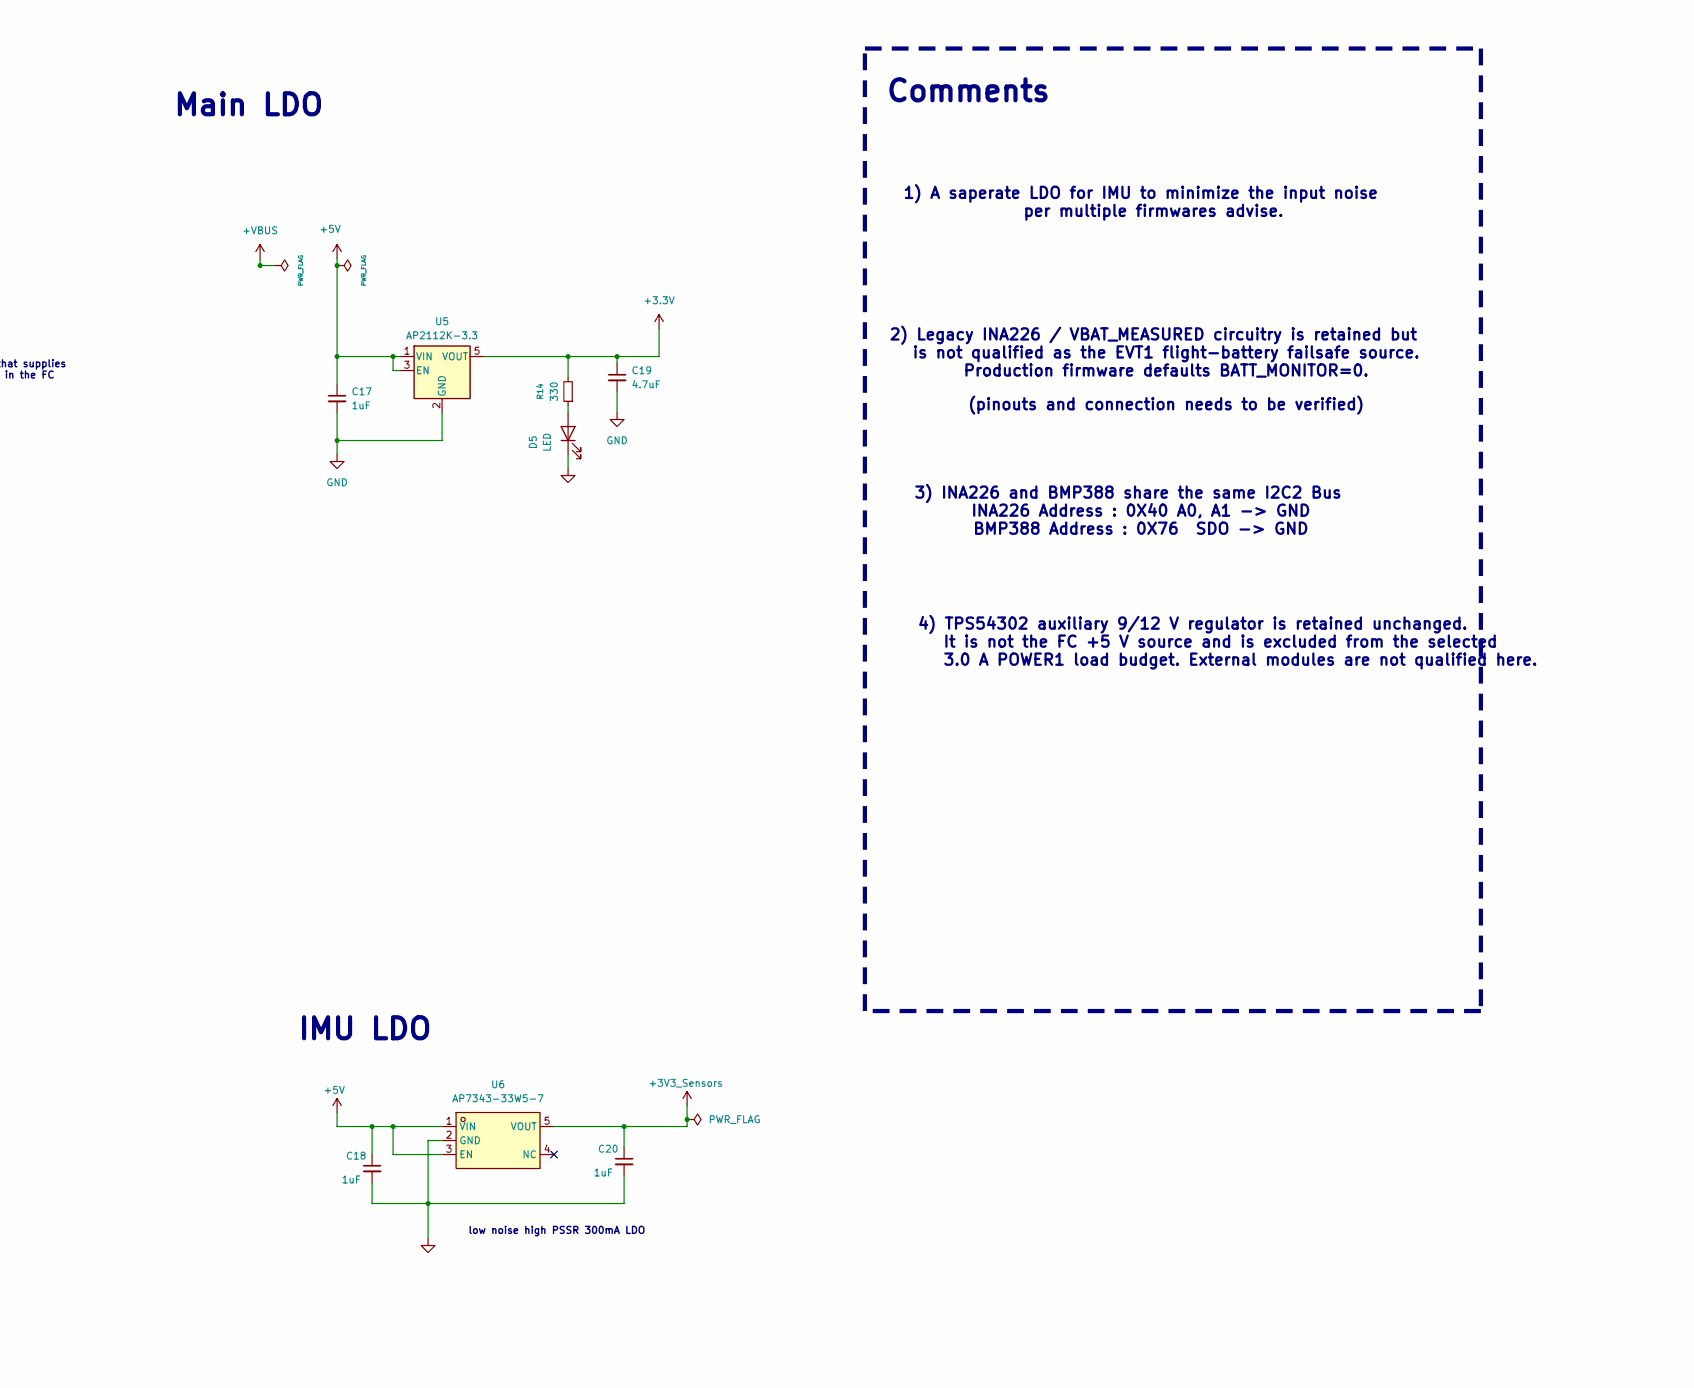
[picture p33: schematic power.kicad_sch, Flight Controller V2, part in row 1, column 2]

Parts:
C1, C3, C10: 10uF; C_0603_1608Metric; Tolerance +/-20%; Voltage Rating 35 V; MPN GRM188R6YA106MA73D
C2, C5: 0.1uF; C_0402_1005Metric; Tolerance +/-10%; Voltage Rating 50 V; MPN GRM155R71H104KE14D
C4: 22uF; C_0805_2012Metric; Tolerance +/-20%; Voltage Rating 35 V; MPN C2012X5R1V226M125AC
C6, C7, C15, C16: 22uF; C_0603_1608Metric; Tolerance +/-20%; Voltage Rating 25 V; MPN GRM188C61E226ME01D
C8: 75pF; C_0402_1005Metric; Tolerance +/-5%; Voltage Rating 50 V; MPN GRM1555C1H750JA01D
C9: 4.7uF; C_0402_1005Metric; Tolerance +/-20%; Voltage Rating 10 V; MPN GRM155R61A475MEAAD
C11, C12: 0.1uF; C_0603_1608Metric; not fitted
C13: 10uF; C_0805_2012Metric; not fitted
C17, C18, C20: 1uF; C_0603_1608Metric; Tolerance +/-10%; Voltage Rating 16 V; MPN GRM188R71C105KA12D
C19: 4.7uF; C_0603_1608Metric; Tolerance +/-10%; Voltage Rating 16 V; MPN GRM188R61C475KE11D
D1: SMF26A; D_SMF; Tolerance N/A; Voltage Rating 26 V standoff; MPN SMF26A-E3-08
D2: BZT52C12-13-F; (zener)SOD-123F_L2.8-W1.8-LS3.7-RD; Tolerance +/-5%; Voltage Rating 12 V; MPN BZT52C12-13-F; LCSC Part C177013
D4, D5: LED; LED_0805_2012Metric; Tolerance N/A; Voltage Rating 5 V rail; MPN LTST-C170KGKT
J1: USB4110GFA; GCT_USB4110GFA; Tolerance N/A; Voltage Rating 20 V; MPN USB4110-GF-A
JP1: 9V/12V; SolderJumper-3_P1.3mm_Open_RoundedPad1.0x1.5mm_NumberLabels
L1: 15uH; IND-SMD_L5.4-W5.2; Tolerance +/-20%; Voltage Rating N/A; MPN XAL5050-153MEB
Q1: AO3407A; Tolerance N/A; Voltage Rating 30 V; MPN AO3407A; LCSC Part C15155
R1: 5.1k; R_0402_1005Metric; Tolerance +/-1%; Voltage Rating 50 V; MPN RC0402FR-075K1L
R2: 5.1k; R_0402_1005Metric; Tolerance +/-1%; Voltage Rating 50 V; MPN RC0402FR-07100KL
R3: 100k; R_0402_1005Metric; Tolerance +/-1%; Voltage Rating 50 V; MPN RC0402FR-0749R9L
R4: 49.9; R_0402_1005Metric; Tolerance +/-1%; Voltage Rating 50 V; MPN RC0402FR-0749R9L
R5: 100k; R_0402_1005Metric; Tolerance +/-1%; Voltage Rating 50 V; MPN RC0402FR-077K15L
R5B1: 7.15K; R_0402_1005Metric; Tolerance +/-1%; Voltage Rating 50 V; MPN RC0402FR-077K15L
R5C1: 5.23k; R_0402_1005Metric; Tolerance +/-1%; Voltage Rating 50 V; MPN RC0402FR-075K23L
R10: 7.5; R_0402_1005Metric; Tolerance +/-1%; Voltage Rating 50 V; MPN RC0402FR-07330RL; not fitted
R11: 7.5; R_0402_1005Metric; Tolerance +/-1%; Voltage Rating 50 V; MPN RC0402FR-07100KL; not fitted
R12: FRM252WFR020TN; R2512; Tolerance +/-1%; Voltage Rating 50 V; MPN RC0402FR-0710KL; LCSC Part C7420049; not fitted
R13, R14: 330; R_0402_1005Metric; Tolerance +/-1%; Voltage Rating 50 V; MPN RC0402FR-0710KL
U1: TPS54302; SOT-23-6; Tolerance N/A; Voltage Rating Per datasheet; MPN TPS54302DDCR
U2: USBLC6-2SC6; SOT-23-6; Tolerance N/A; Voltage Rating Per datasheet; MPN USBLC6-2SC6
U3: INA226; VSSOP-10_3x3mm_P0.5mm; not fitted
U5: AP2112K-3.3; SOT-23-5; Tolerance N/A; Voltage Rating Per datasheet; MPN AP2112K-3.3TRG1
U6: AP7343-33W5-7; (AP7343 )SOT-25_L3.0-W1.6-P0.95-LS2.8-BL; Tolerance N/A; Voltage Rating Per datasheet; MPN AP7343-33W5-7; LCSC Part C460383

Connections:
+3.3V: C19.1, R14.2, U5.5 (VOUT); also elsewhere on the board
+3V3_Sensors: C20.1, U6.5 (VOUT); also elsewhere on the board
+5V: C12.1, C13.1, C15.2, C16.2, C17.1, C18.1, R13.2, U3.6 (VS), U5.1 (VIN), U5.3 (EN), U6.1 (VIN), U6.3 (EN); also elsewhere on the board
+VBAT: D1.1 (A1), Q1.3 (D); also elsewhere on the board
+VBUS: C9.1, J1.A4/B9 (VBUS), J1.B4/A9 (VBUS), U2.5 (VBUS)
+pwr_out: C6.1, C7.1, L1.2, R4.1; also elsewhere on the board
/Power/A5: J1.A5 (CC1), R1.2
/Power/B5: J1.B5 (CC2), R2.2
/Power/D+: J1.A6 (DP1), J1.B6 (DP2), U2.3 (I/O2)
/Power/D-: J1.A7 (DN1), J1.B7 (DN2), U2.1 (I/O1)
/Power/FB: C8.2, JP1.2 (C), R5.2, U1.4 (FB)
/Power/FB_9V: JP1.3 (B), R5B1.1
/Power/FB_12V: JP1.1 (A), R5C1.1
/Power/SW: C5.2, L1.1, U1.2 (SW)
/Power/boot: C5.1, U1.6 (BOOT)
GND: C1.2, C2.2, C3.2, C4.2, C6.2, C7.2, C9.2, C10.1, C12.2, C13.2, C15.1, C16.1, C17.2, C18.2, C19.2, C20.2, D1.2 (A2), D4.1 (K), D5.1 (K), J1.A1/B12 (GND), J1.B1/A12 (GND), J1.S1 (GND), J1.S2 (GND), J1.S3 (GND), J1.S4 (GND), R1.1, R2.1, R3.1, R5B1.2, R5C1.2, U1.1 (GND), U2.2 (GND), U3.7 (GND), U5.2 (GND), U6.2 (GND); also elsewhere on the board
unnamed: C8.1, R4.2, R5.1
unnamed: C11.1, R10.1, U3.10 (Vin+)
unnamed: C11.2, R11.1, U3.9 (Vin-)
unnamed: D2.2 (A), Q1.1 (G), R3.2
unnamed: D4.2 (A), R13.1
unnamed: D5.2 (A), R14.1
unnamed: R11.2, R12.2
USB_DN: U2.6 (I/O1); also elsewhere on the board
USB_DP: U2.4 (I/O2); also elsewhere on the board
VBAT_Filtered: C1.1, C2.1, C3.1, C4.1, C10.2, D2.1 (K), Q1.2 (S), R10.2, R12.1, U1.3 (VIN)

Notes on the sheet:
FC +5V buck removed - use external POWER1
Power System
2) Legacy INA226 / VBAT_MEASURED circuitry is retained but is not qualified as the EVT1 flight-battery failsafe source. Production firmware defaults BATT_MONITOR=0.
low noise high PSSR 300mA LDO
(pinouts and connection needs to be verified)
VBAT_MEASURED is the node that supplies each sensor and peripheral in the FC
9V output
12V output
IMU LDO
TVS and reverse polarity protection
4) TPS54302 auxiliary 9/12 V regulator is retained unchanged. It is not the FC +5 V source and is excluded from the selected 3.0 A POWER1 load budget. External modules are not qualified here.
sharing same bus as BMP388
Comments
3) INA226 and BMP388 share the same I2C2 Bus INA226 Address : 0X40 A0, A1 -> GND BMP388 Address : 0X76 SDO -> GND
14.8V
Current Sensing
12V or 9V switching regulator
USB-C connection
1) A saperate LDO for IMU to minimize the input noise per multiple firmwares advise.
Main LDO
enable pin max leave floting to enable the IC. operating on VIN UVLO. turns on when VIN > 4V, turn off when VIN < 3.6V

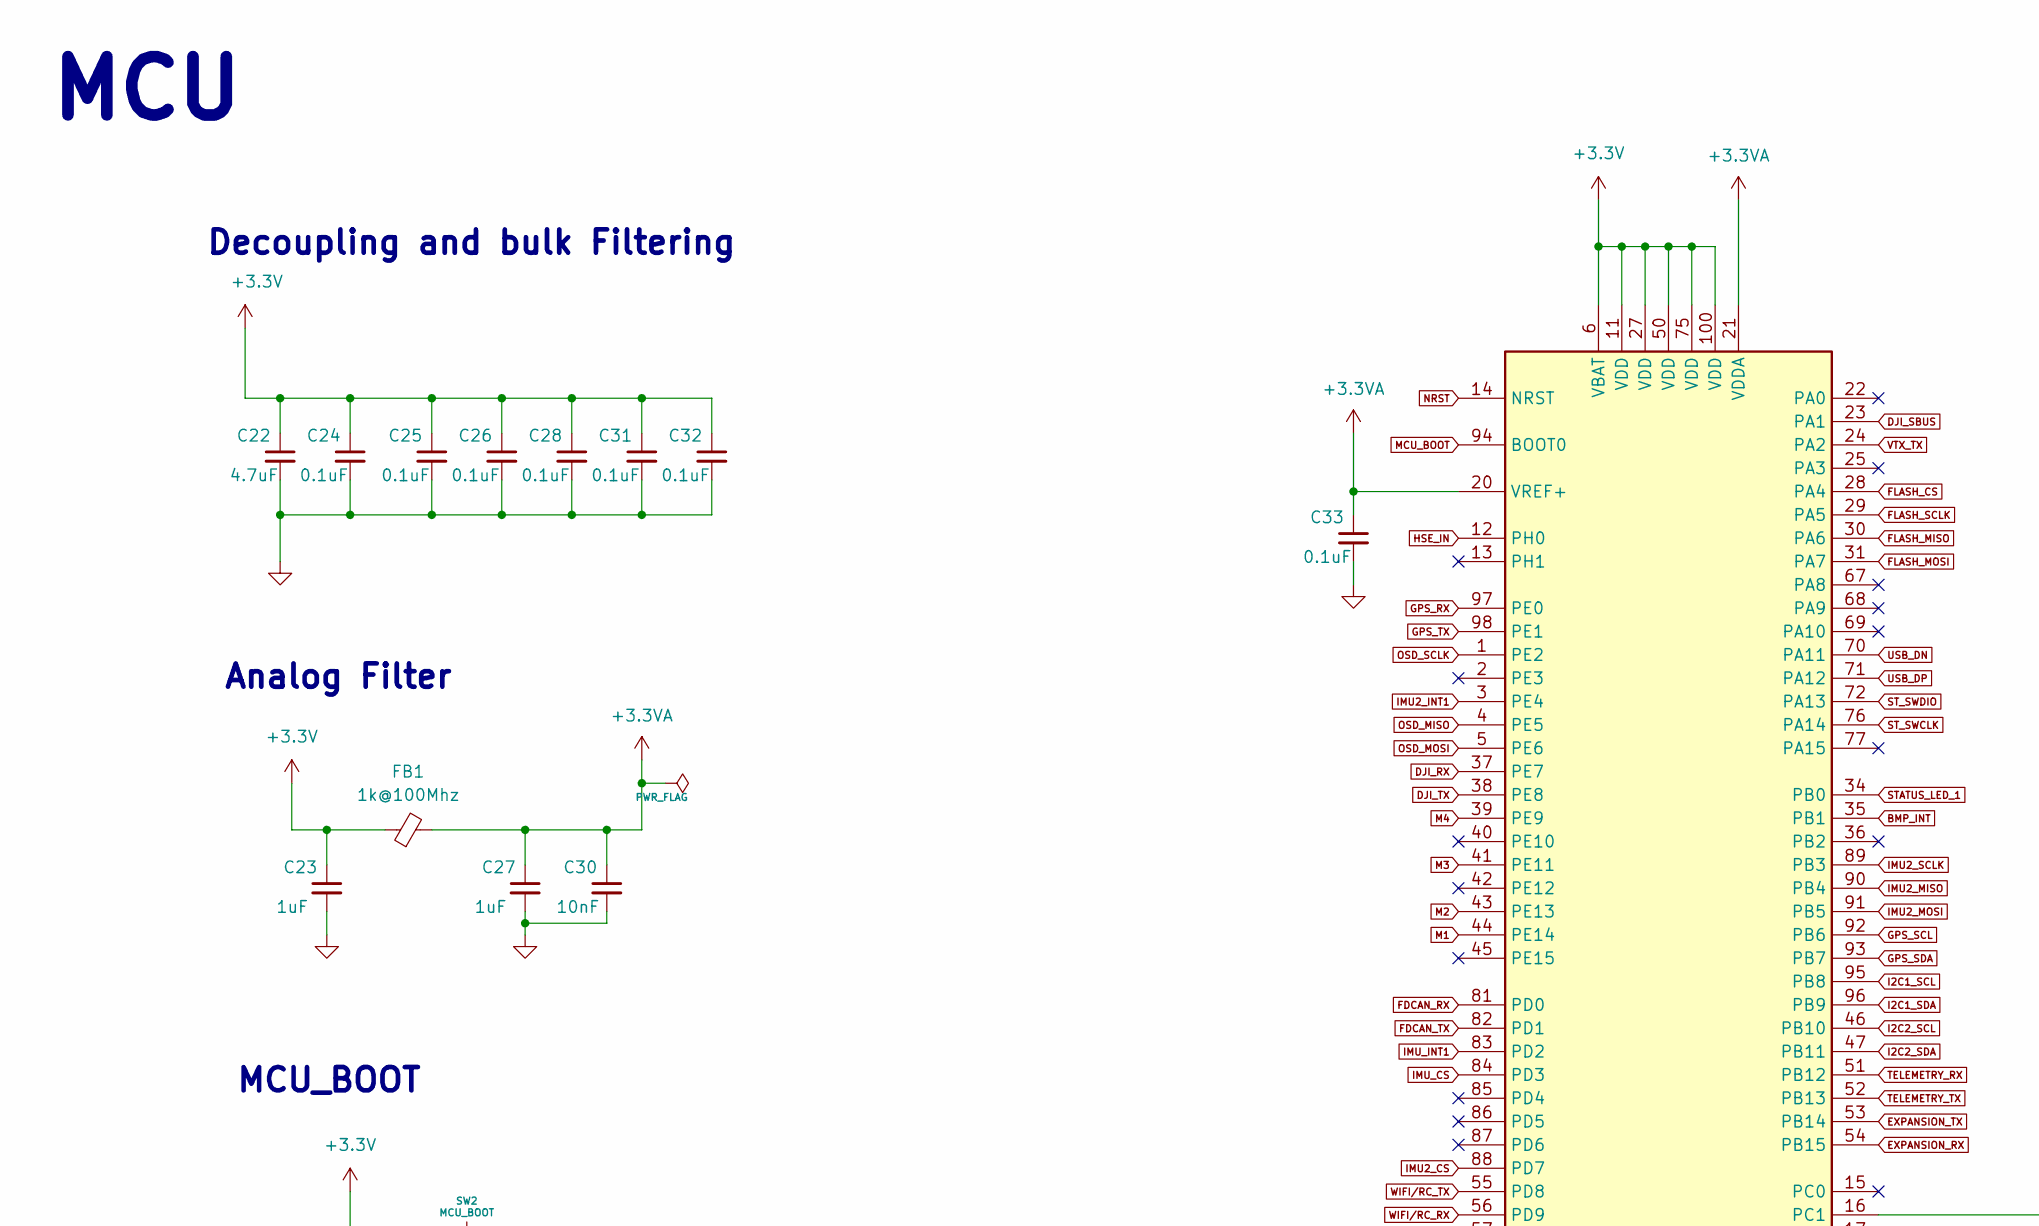
[picture p34: schematic MCU.kicad_sch, Flight Controller V2, part in row 1, column 1]

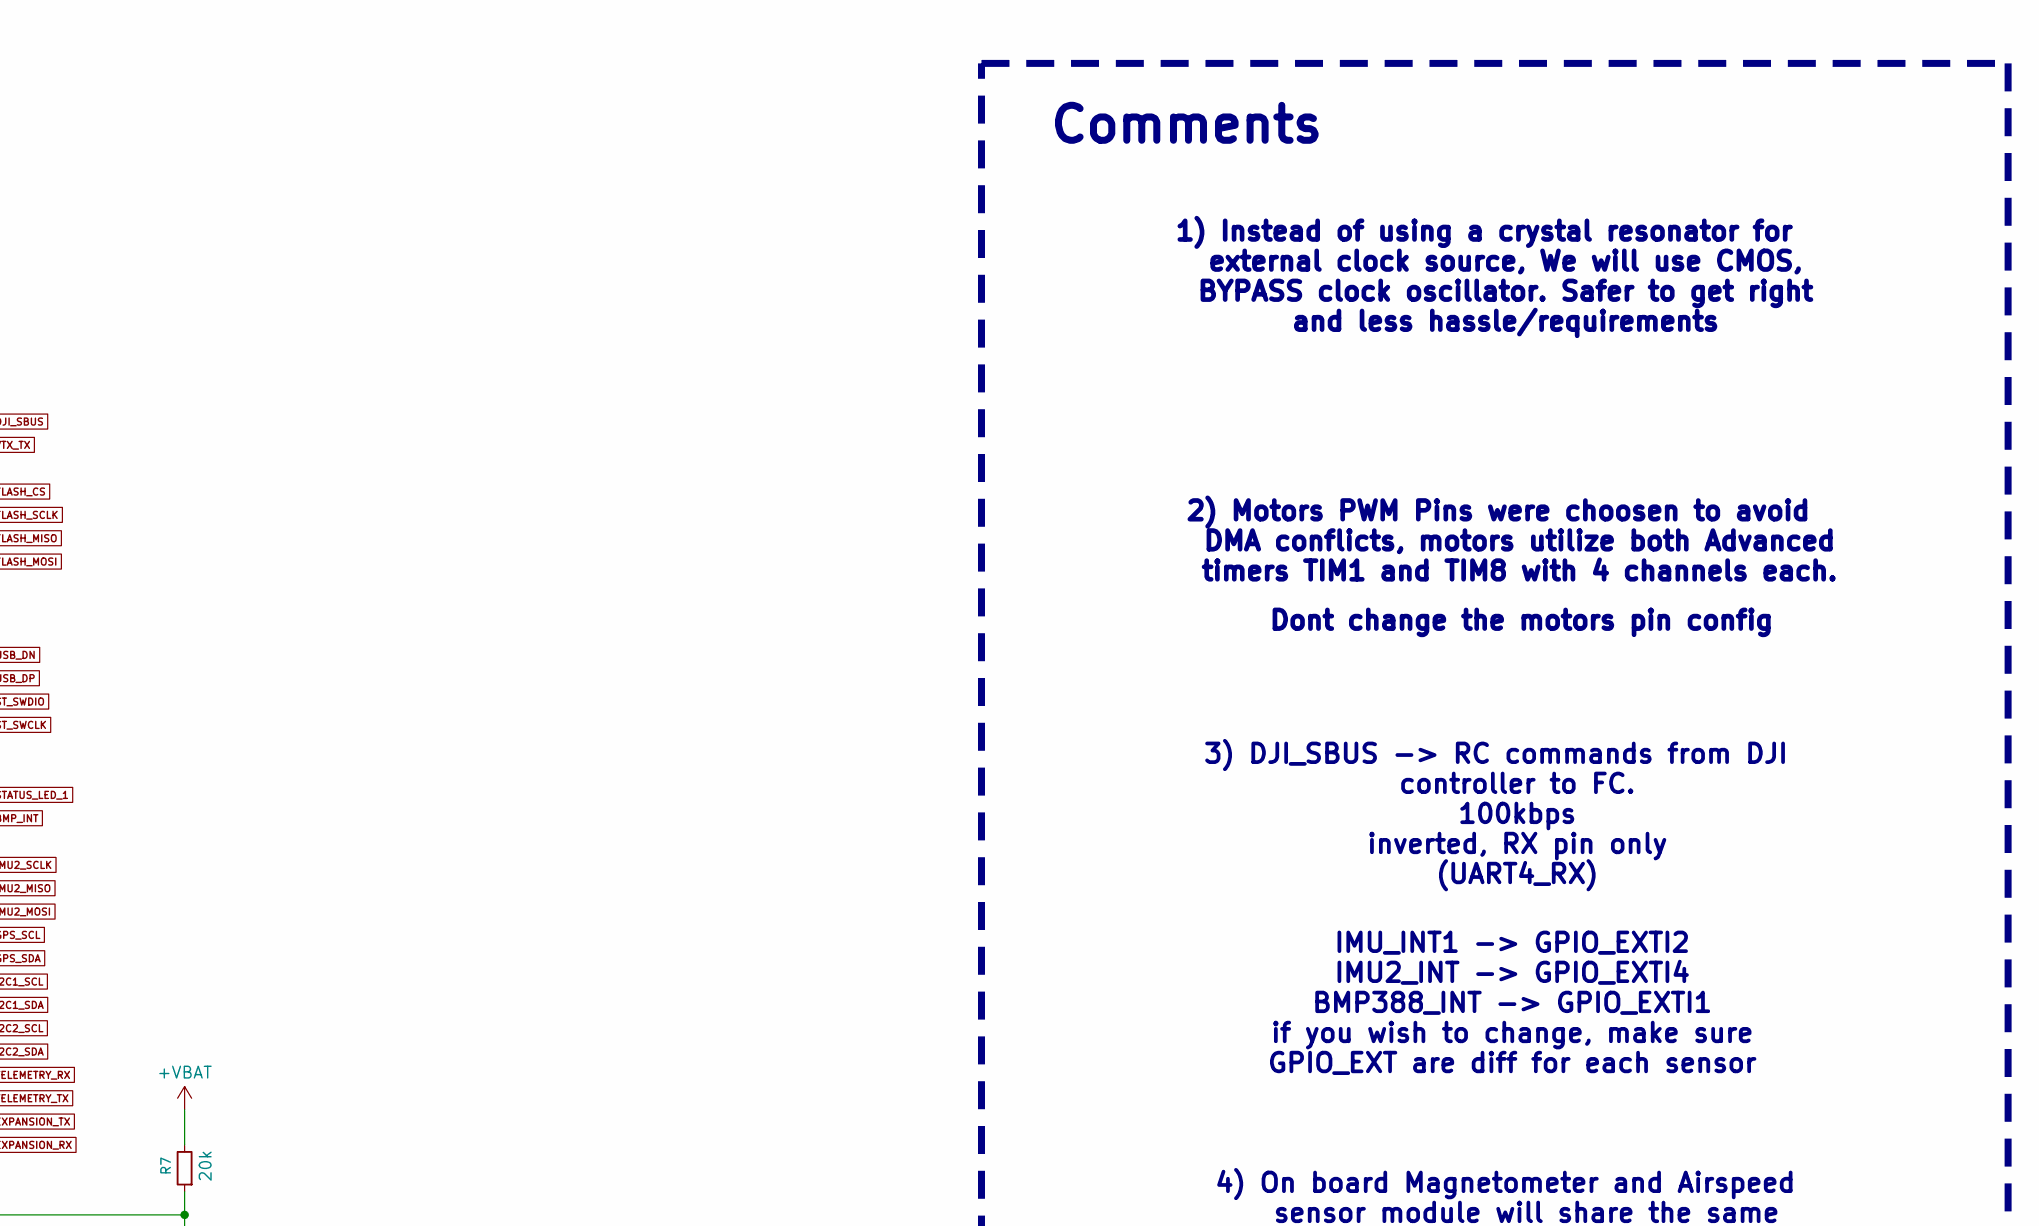
[picture p35: schematic MCU.kicad_sch, Flight Controller V2, part in row 1, column 2]

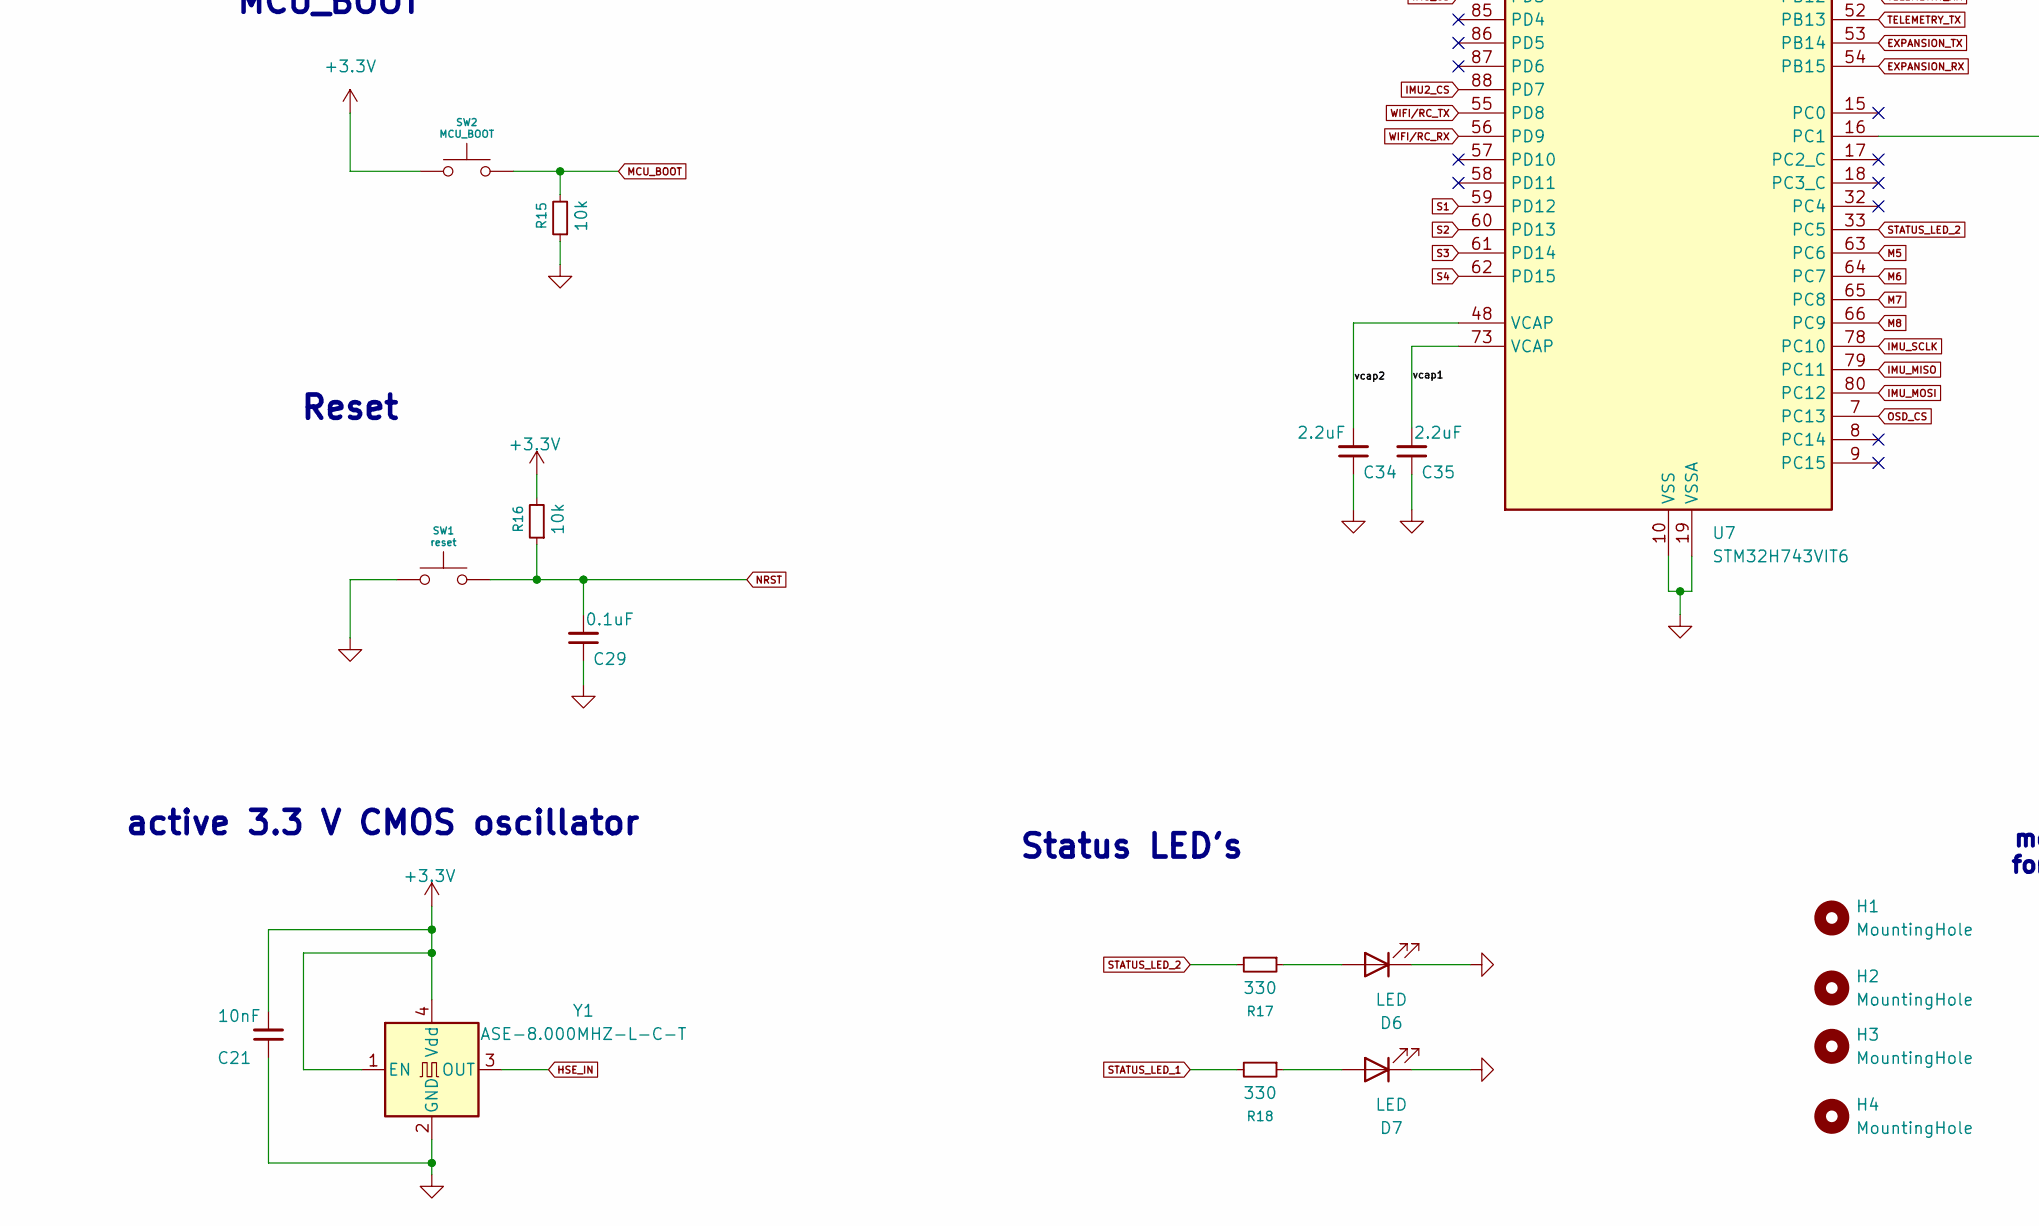
[picture p36: schematic MCU.kicad_sch, Flight Controller V2, part in row 2, column 1]

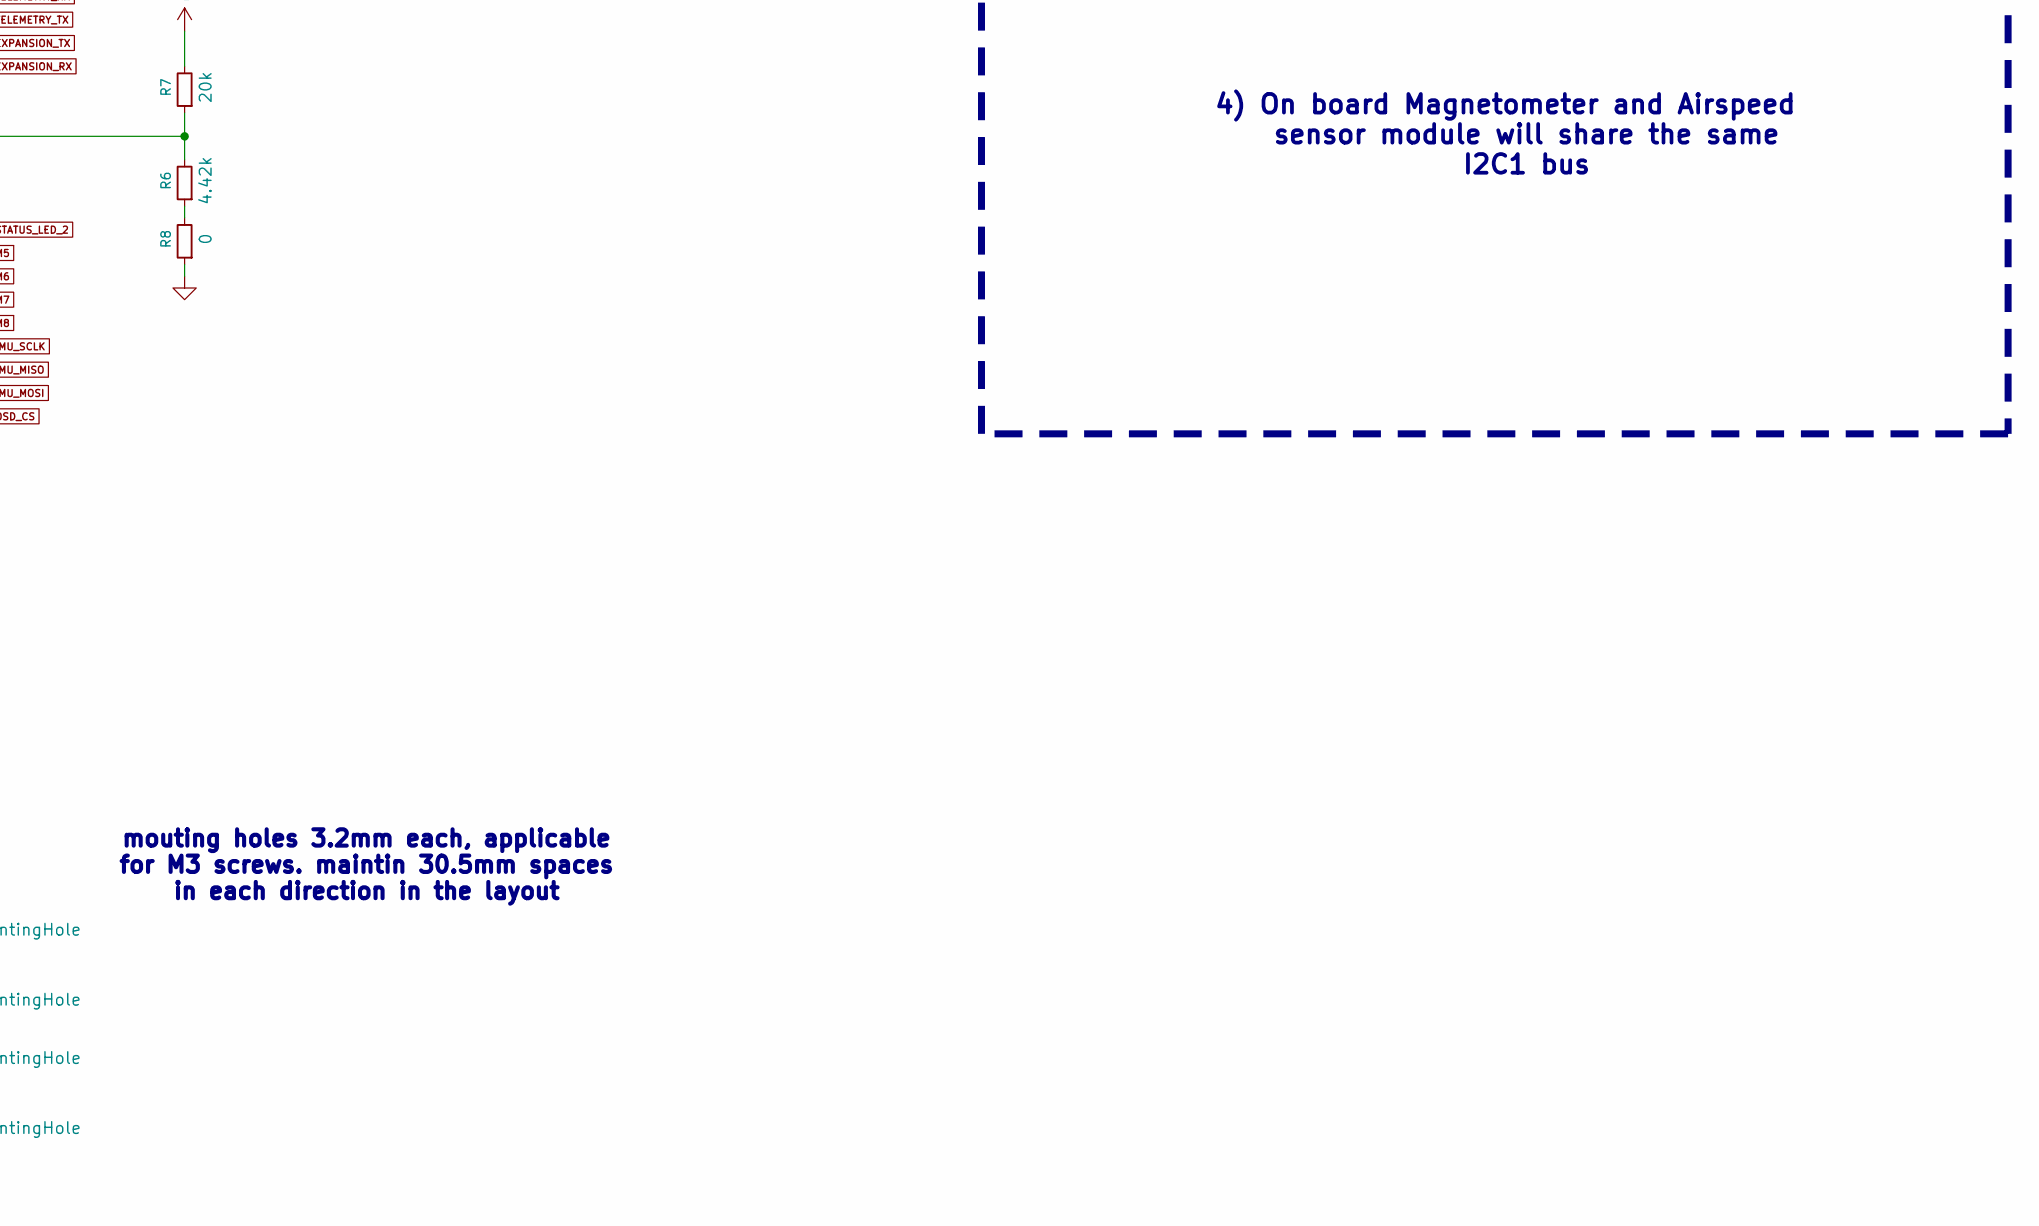
[picture p37: schematic MCU.kicad_sch, Flight Controller V2, part in row 2, column 2]

Parts:
C21: 10nF; C_0603_1608Metric; Tolerance +/-10%; Voltage Rating 50 V; MPN GRM188R71H103KA01D
C22: 4.7uF; C_0603_1608Metric; Tolerance +/-10%; Voltage Rating 16 V; MPN GRM188R61C475KE11D
C23, C27: 1uF; C_0603_1608Metric; Tolerance +/-10%; Voltage Rating 16 V; MPN GRM188R71C105KA12D
C24, C25, C26, C28, C29, C31, C32: 0.1uF; C_0402_1005Metric; Tolerance +/-10%; Voltage Rating 50 V; MPN GRM155R71H104KE14D
C30: 10nF; C_0402_1005Metric; Tolerance +/-10%; Voltage Rating 50 V; MPN GRM155R71H103KA88D
C33: 0.1uF; C_0603_1608Metric; Tolerance +/-10%; Voltage Rating 50 V; MPN GRM188R71H104KA93D
C34, C35: 2.2uF; C_0603_1608Metric; Tolerance +/-10%; Voltage Rating 16 V; MPN GRM188R71C225KE15D
D6, D7: LED; LED_0805_2012Metric; Tolerance N/A; Voltage Rating 5 V rail; MPN LTST-C170KGKT
FB1: 1k@100Mhz; L_0603_1608Metric; Tolerance +/-25%; Voltage Rating N/A; MPN BLM18AG102SN1D
H1, H2, H3, H4: MountingHole; MountingHole_3.2mm_M3_Pad_Via
R6: 4.42k; R_0402_1005Metric; Tolerance +/-1%; Voltage Rating 50 V; MPN RC0402FR-075K23L
R7: 20k; R_0402_1005Metric; Tolerance +/-1%; Voltage Rating 50 V; MPN RC0402FR-0720KL
R8: 0; R_0402_1005Metric; Tolerance +/-5%; Voltage Rating 50 V; MPN RC0402JR-070RL
R15, R16: 10k; R_0402_1005Metric; Tolerance +/-1%; Voltage Rating 50 V; MPN RC0402FR-0749R9L
R17: 330; R_0402_1005Metric; Tolerance +/-1%; Voltage Rating 50 V; MPN RC0402FR-07330RL
R18: 330; R_0402_1005Metric; Tolerance +/-1%; Voltage Rating 50 V; MPN RC0402FR-075K1L
SW1: reset; SW_Push_SPST_NO_Alps_SKRK; Tolerance N/A; Voltage Rating 12 V; MPN SKRKAEE020
SW2: MCU_BOOT; SW_Push_SPST_NO_Alps_SKRK; Tolerance N/A; Voltage Rating 12 V; MPN SKRKAEE020
U7: STM32H743VIT6; LQFP-100_14x14mm_P0.5mm; Tolerance N/A; Voltage Rating Per datasheet; MPN STM32H743VIT6
Y1: ASE-8.000MHZ-L-C-T; Oscillator_SMD_Abracon_ASE-4Pin_3.2x2.5mm; Tolerance +/-25 ppm; Voltage Rating 3.3 V; MPN ASE-8.000MHZ-L-C-T

Connections:
+3.3V: C21.2, C22.1, C23.1, C24.1, C25.1, C26.1, C28.1, C31.1, C32.1, FB1.1, R16.2, SW2.1, U7.6 (VBAT), U7.11 (VDD), U7.27 (VDD), U7.50 (VDD), U7.75 (VDD), U7.100 (VDD), Y1.1 (EN), Y1.4 (Vdd); also elsewhere on the board
+3.3VA: C27.1, C30.1, C33.1, FB1.2, U7.20 (VREF+), U7.21 (VDDA)
+VBAT: R7.2; also elsewhere on the board
/MCU/vcap1: C35.2, U7.73 (VCAP)
/MCU/vcap2: C34.2, U7.48 (VCAP)
BMP_INT: U7.35 (PB1); also elsewhere on the board
DJI_RX: U7.37 (PE7); also elsewhere on the board
DJI_SBUS: U7.23 (PA1); also elsewhere on the board
DJI_TX: U7.38 (PE8); also elsewhere on the board
EXPANSION_RX: U7.54 (PB15); also elsewhere on the board
EXPANSION_TX: U7.53 (PB14); also elsewhere on the board
FDCAN_RX: U7.81 (PD0); also elsewhere on the board
FDCAN_TX: U7.82 (PD1); also elsewhere on the board
FLASH_CS: U7.28 (PA4); also elsewhere on the board
FLASH_MISO: U7.30 (PA6); also elsewhere on the board
FLASH_MOSI: U7.31 (PA7); also elsewhere on the board
FLASH_SCLK: U7.29 (PA5); also elsewhere on the board
GND: C21.1, C22.2, C23.2, C24.2, C25.2, C26.2, C27.2, C28.2, C29.1, C30.2, C31.2, C32.2, C33.2, C34.1, C35.1, D6.1 (K), D7.1 (K), R8.1, R15.1, SW1.1, U7.10 (VSS), U7.19 (VSSA), U7.26 (VSS), U7.49 (VSS), U7.74 (VSS), U7.99 (VSS), Y1.2 (GND); also elsewhere on the board
GPS_RX: U7.97 (PE0); also elsewhere on the board
GPS_SCL: U7.92 (PB6); also elsewhere on the board
GPS_SDA: U7.93 (PB7); also elsewhere on the board
GPS_TX: U7.98 (PE1); also elsewhere on the board
HSE_IN: U7.12 (PH0), Y1.3 (OUT)
I2C1_SCL: U7.95 (PB8); also elsewhere on the board
I2C1_SDA: U7.96 (PB9); also elsewhere on the board
I2C2_SCL: U7.46 (PB10); also elsewhere on the board
I2C2_SDA: U7.47 (PB11); also elsewhere on the board
IMU2_CS: U7.88 (PD7); also elsewhere on the board
IMU2_INT1: U7.3 (PE4); also elsewhere on the board
IMU2_MISO: U7.90 (PB4); also elsewhere on the board
IMU2_MOSI: U7.91 (PB5); also elsewhere on the board
IMU2_SCLK: U7.89 (PB3); also elsewhere on the board
IMU_CS: U7.84 (PD3); also elsewhere on the board
IMU_INT1: U7.83 (PD2); also elsewhere on the board
IMU_MISO: U7.79 (PC11); also elsewhere on the board
IMU_MOSI: U7.80 (PC12); also elsewhere on the board
IMU_SCLK: U7.78 (PC10); also elsewhere on the board
M1: U7.44 (PE14); also elsewhere on the board
M2: U7.43 (PE13); also elsewhere on the board
M3: U7.41 (PE11); also elsewhere on the board
M4: U7.39 (PE9); also elsewhere on the board
M5: U7.63 (PC6); also elsewhere on the board
M6: U7.64 (PC7); also elsewhere on the board
M7: U7.65 (PC8); also elsewhere on the board
M8: U7.66 (PC9); also elsewhere on the board
MCU_BOOT: R15.2, SW2.2, U7.94 (BOOT0)
NRST: C29.2, R16.1, SW1.2, U7.14 (NRST)
unnamed: D6.2 (A), R17.1
unnamed: D7.2 (A), R18.1
unnamed: R6.1, R8.2
unnamed: R6.2, R7.1, U7.16 (PC1)
OSD_CS: U7.7 (PC13); also elsewhere on the board
OSD_MISO: U7.4 (PE5); also elsewhere on the board
OSD_MOSI: U7.5 (PE6); also elsewhere on the board
OSD_SCLK: U7.1 (PE2); also elsewhere on the board
S1: U7.59 (PD12); also elsewhere on the board
S2: U7.60 (PD13); also elsewhere on the board
S3: U7.61 (PD14); also elsewhere on the board
S4: U7.62 (PD15); also elsewhere on the board
STATUS_LED_1: R18.2, U7.34 (PB0)
STATUS_LED_2: R17.2, U7.33 (PC5)
ST_SWCLK: U7.76 (PA14); also elsewhere on the board
ST_SWDIO: U7.72 (PA13); also elsewhere on the board
TELEMETRY_RX: U7.51 (PB12); also elsewhere on the board
TELEMETRY_TX: U7.52 (PB13); also elsewhere on the board
USB_DN: U7.70 (PA11); also elsewhere on the board
USB_DP: U7.71 (PA12); also elsewhere on the board
VTX_TX: U7.24 (PA2); also elsewhere on the board
WIFI/RC_RX: U7.56 (PD9); also elsewhere on the board
WIFI/RC_TX: U7.55 (PD8); also elsewhere on the board

Notes on the sheet:
Analog Filter
Reset
4) On board Magnetometer and Airspeed sensor module will share the same I2C1 bus
mouting holes 3.2mm each, applicable for M3 screws. maintin 30.5mm spaces in each direction in the layout
1) Instead of using a crystal resonator for external clock source, We will use CMOS, BYPASS clock oscillator. Safer to get right and less hassle/requirements
Comments
MCU
2) Motors PWM Pins were choosen to avoid DMA conflicts, motors utilize both Advanced timers TIM1 and TIM8 with 4 channels each.
3) DJI_SBUS -> RC commands from DJI controller to FC. 100kbps inverted, RX pin only (UART4_RX)
MCU_BOOT
active 3.3 V CMOS oscillator
IMU_INT1 -> GPIO_EXTI2 IMU2_INT -> GPIO_EXTI4 BMP388_INT -> GPIO_EXTI1 if you wish to change, make sure GPIO_EXT are diff for each sensor
Dont change the motors pin config
Decoupling and bulk Filtering
Status LED's
