desanv01/Flight-Controller-V2/fabrication/pcbway/source/hardware/Flight Controller.kicad_pcb

## KiCad design fabrication/pcbway/source/hardware/Flight Controller.kicad_pcb (continued)

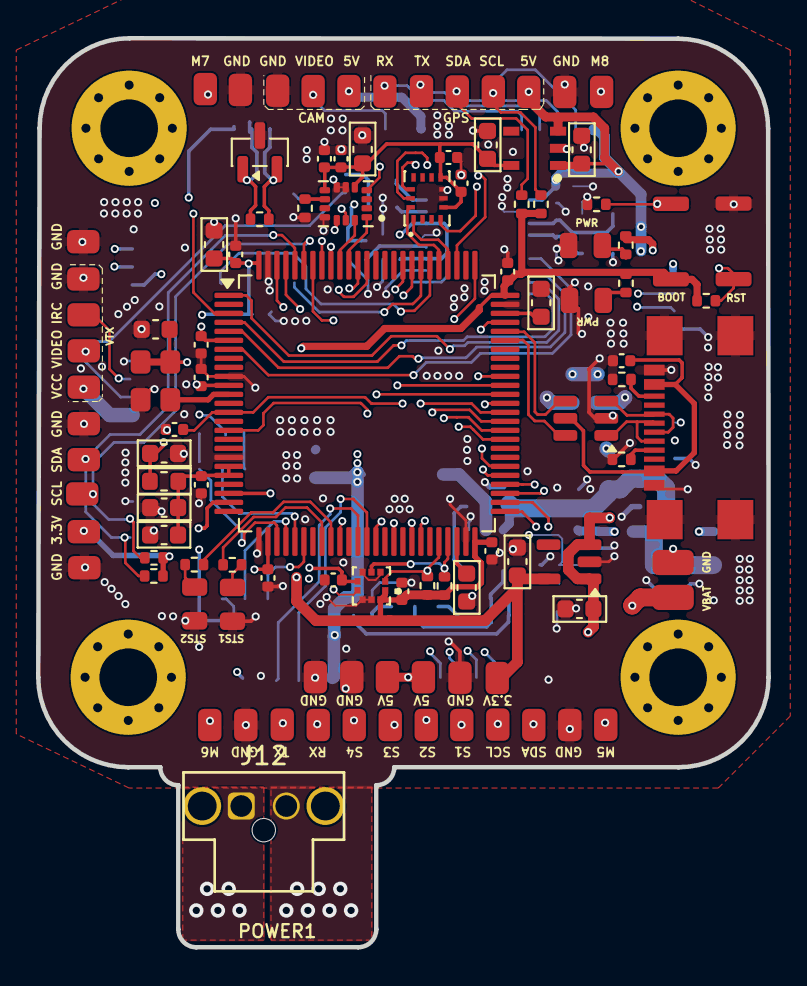
[picture p44: board Flight Controller.kicad_pcb from above]

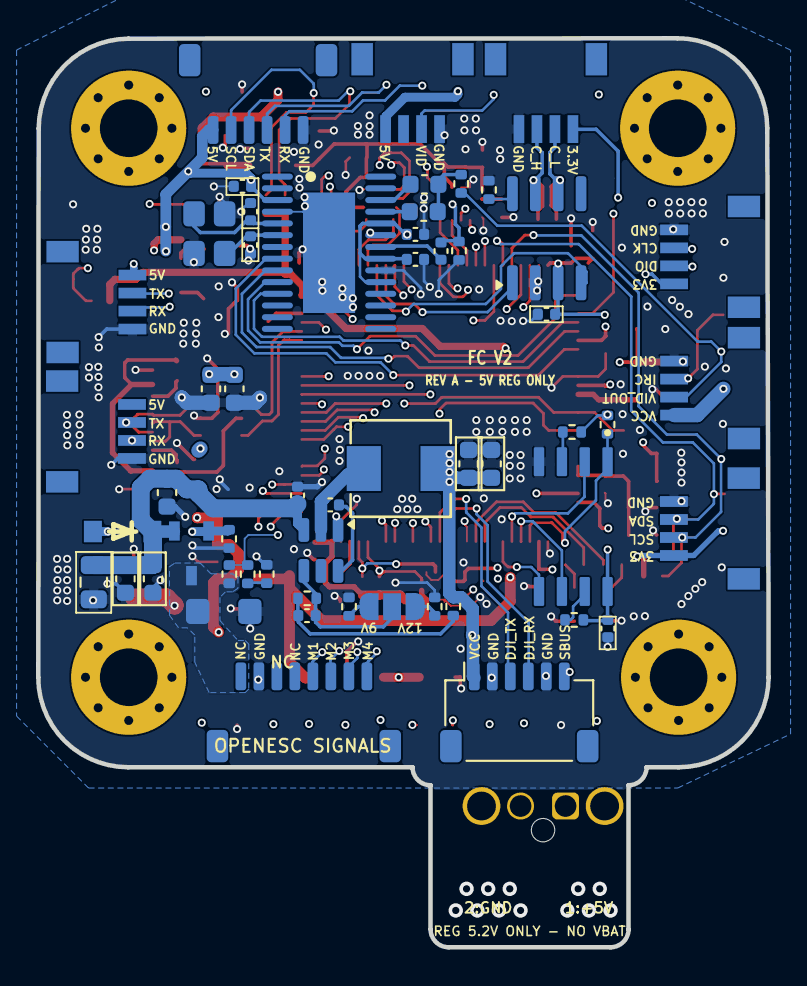
[picture p45: board Flight Controller.kicad_pcb from below]

Board: 6 copper layers, 40.6 x 50.5 mm, 162 parts (55 on the bottom side), 102 nets.
