desanv01/Flight-Controller-V2/fabrication/jlcpcb/firmware/targets/FCV2/defaults-postqual-bidir.parm

# Apply only after scope/logic-analyzer qualification with propellers removed.
MOT_PWM_TYPE 5
SERVO_BLH_BDMASK 15
SERVO_DSHOT_ESC 1
