desanv01/Flight-Controller-V2/fabrication/jlcpcb/firmware/targets/FCV2/defaults.parm

# ENGINEERING VALIDATION EVT1 — safe first-bench defaults, propellers removed.
FRAME_CLASS 1
FRAME_TYPE 1
SERIAL2_PROTOCOL 23
RC_PROTOCOLS 512
MOT_PWM_TYPE 5
SERVO1_FUNCTION 33
SERVO2_FUNCTION 34
SERVO3_FUNCTION 35
SERVO4_FUNCTION 36
SERVO_BLH_POLES 14
SERVO_BLH_BDMASK 0
SERVO_DSHOT_ESC 1
BATT_MONITOR 0
OSD_TYPE 0
