desanv01/Flight-Controller-V2/(commit log)

2026-10-14 docs: circuit selection and subsystem boundaries
2026-10-14 docs: kicad foundation
2026-10-14 docs: stm32h743 core capture
2026-10-14 docs: power tree and correction sequence
2026-10-14 docs: imu and barometer capture
2026-10-14 docs: schematic, footprint and bom review
2026-10-14 hardware: recover pre-interface schematic entry snapshot
    [01_mcu_core.kicad_sch, 02_power.kicad_sch, 03_sensors.kicad_sch, 04_esc.kicad_sch, 05_external_ports.kicad_sch, 06_can.kicad_sch, 07_usb_debug.kicad_sch, 08_storage_status.kicad_sch]
2026-10-14 hardware: import credited upstream source baseline
    [Flight Controller.kicad_pcb, Flight Controller.kicad_sch, MCU.kicad_sch, Sensors.kicad_sch, connectors.kicad_sch, power.kicad_sch]
2026-10-14 hardware: import external-power and signal-only ESC EVT1
    [Flight Controller.kicad_pcb, Flight Controller.kicad_sch, MCU.kicad_sch, Sensors.kicad_sch, connectors.kicad_sch, power.kicad_sch]
2026-10-14 hardware: import PCBWay manufacturing metadata variant
    [Flight Controller.kicad_pcb, MCU.kicad_sch, Sensors.kicad_sch, connectors.kicad_sch, power.kicad_sch]
2026-10-14 docs: preserve bench integration and wiring guidance
2026-10-14 archive: index unique source experiments and reference links
    [FC_EVT1-BOM.csv, FC_EVT1-JLCPCB-BOM-FINAL.csv, FC_EVT1_PCBWAY-BOM-raw.csv, FC_EVT1_PCBWAY-DNP-and-NonPurchased.csv, FC_EVT1_PCBWAY-SMT-Centroid-Bottom.csv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]
2026-10-14 docs: publish neutral engineering source, manufacturing and portfolio overview
    [(HSE)OSC-SMD_4P-L3.2-W2.5-CJ13-320001210A20.step, (zener)SOD-123FL_L2.8-W1.8-LS3.7-RD-1.step, 4pconnector1mm.step, 8pconn.step, AO3407A.step, AP7343 .step, AT7456E.step, BMI270.step]
2026-10-14 docs: apply complete public naming correction
    [SHA256SUMS.csv]
